Lwao/projeto-instalacoes-eletrica/diagramas/prumada-2-600.jpg

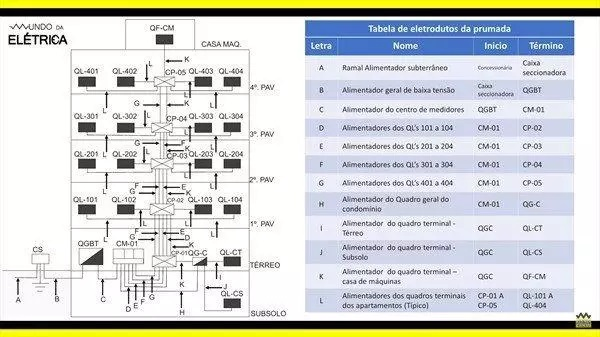
diagramas/prumada-2-600.jpg
