Lwao/projeto-instalacoes-eletrica/diagramas/detalhe2.pdf

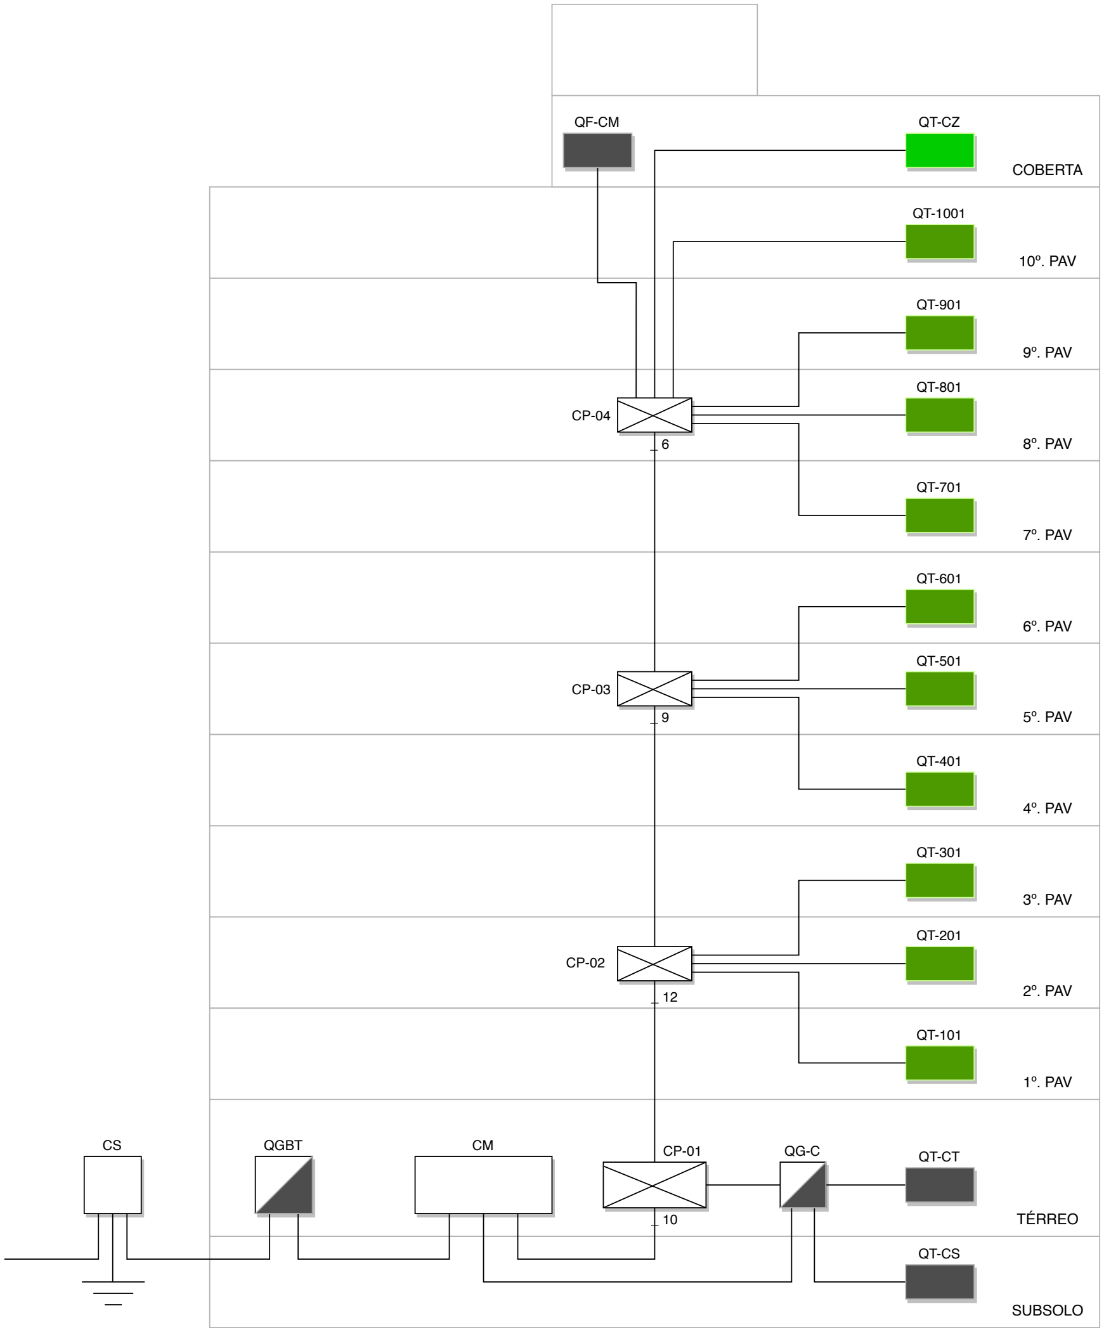
[picture p3: figure]
QGBT; SUBSOLO; TÉRREO; 1º. PAV; 2º. PAV; 3º. PAV; 4º. PAV; 5º. PAV; 6º. PAV; 7º. PAV; 8º. PAV; 9º. PAV; 10º. PAV; COBERTA
