Lwao/projeto-instalacoes-eletrica/exportacao/Anexos/Outros/partida.pdf

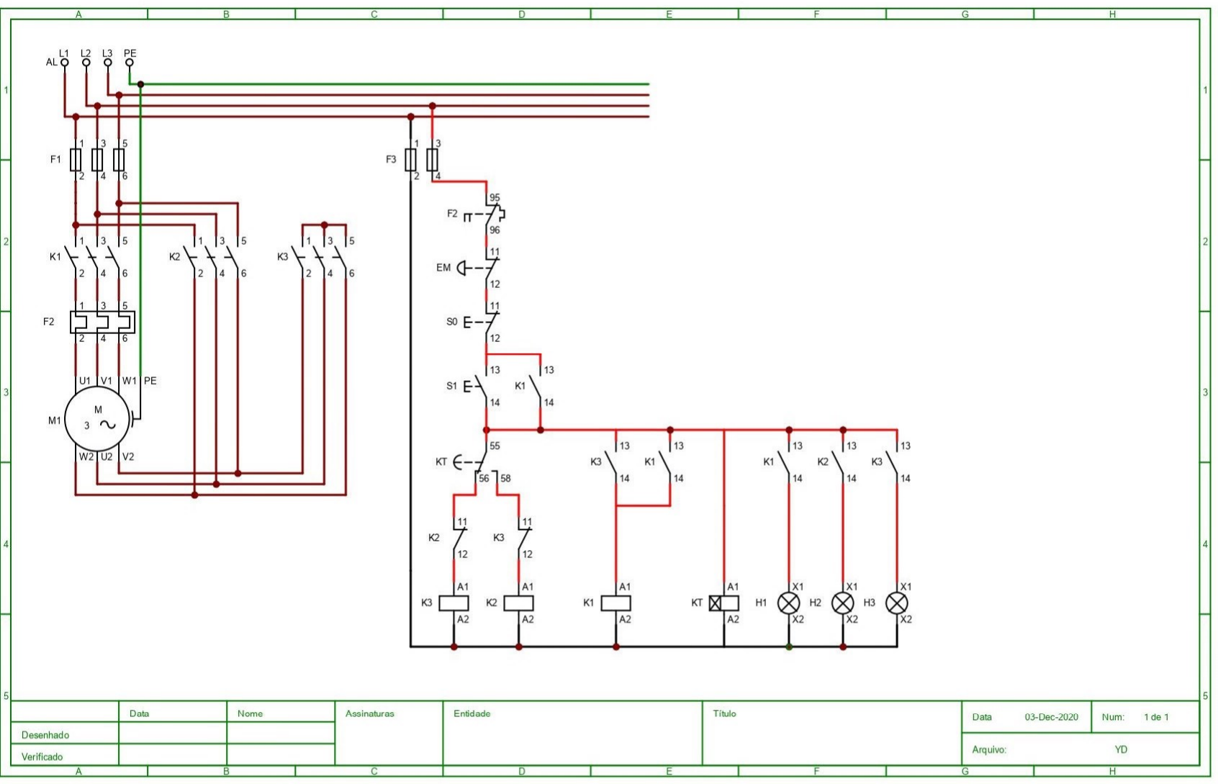
[picture p4: page 1]
