Lwao/projeto-instalacoes-eletrica/diagramas/0001.jpg

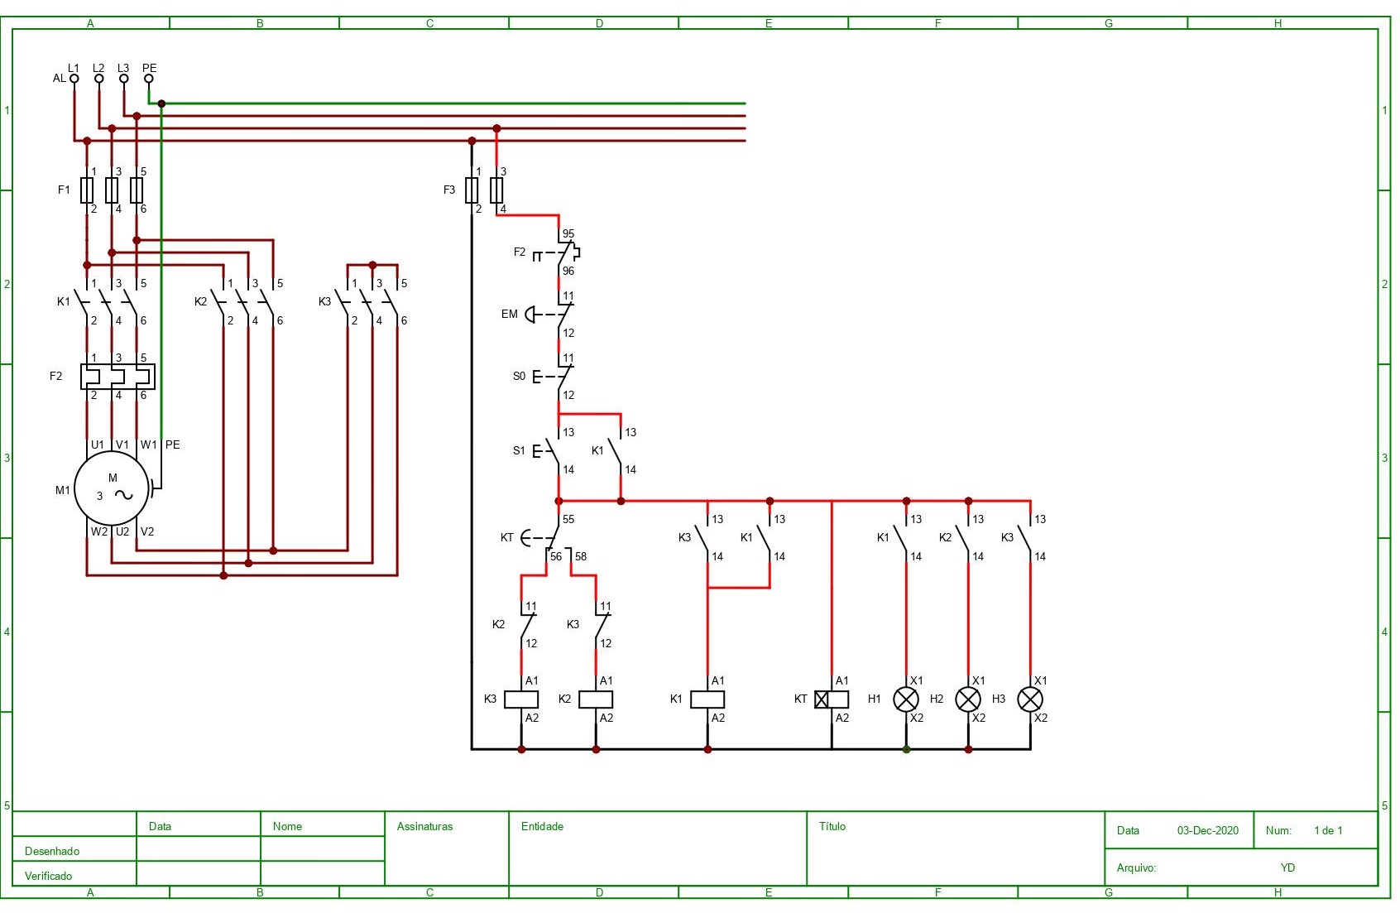
diagramas/0001.jpg
