Lwao/projeto-instalacoes-eletrica/diagramas/elevator.jpg

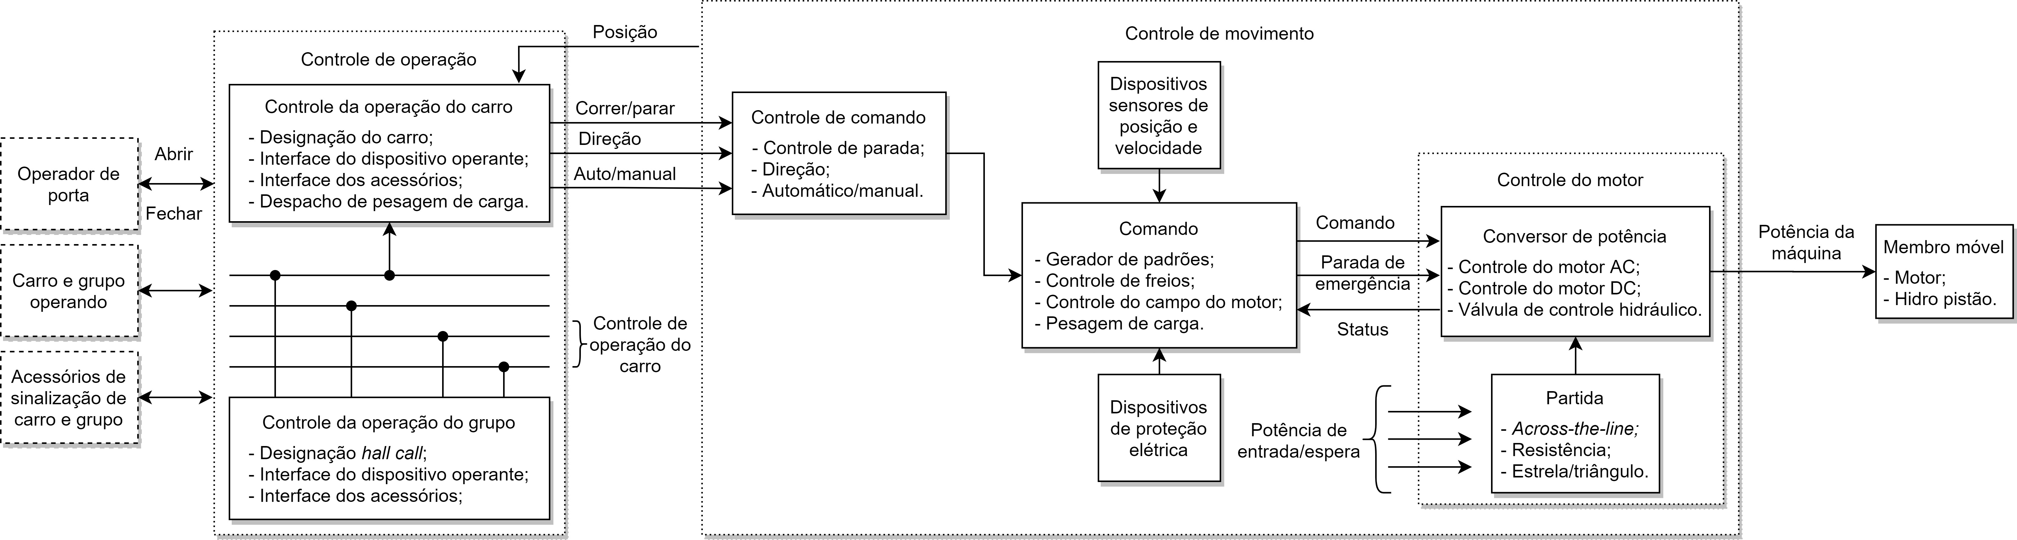
diagramas/elevator.jpg
