Lwao/projeto-instalacoes-eletrica/diagramas/esq_vert.png

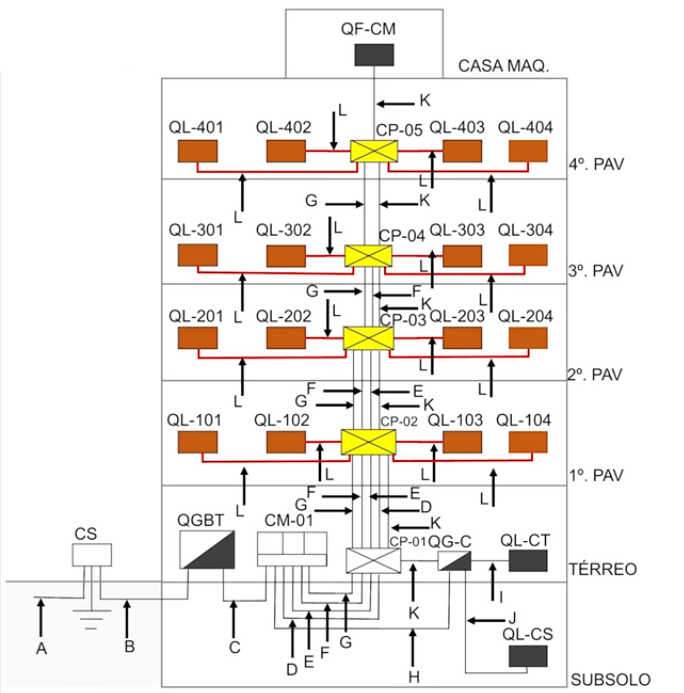
diagramas/esq_vert.png
