Lwao/projeto-instalacoes-eletrica/diagramas/unifilar.jpg

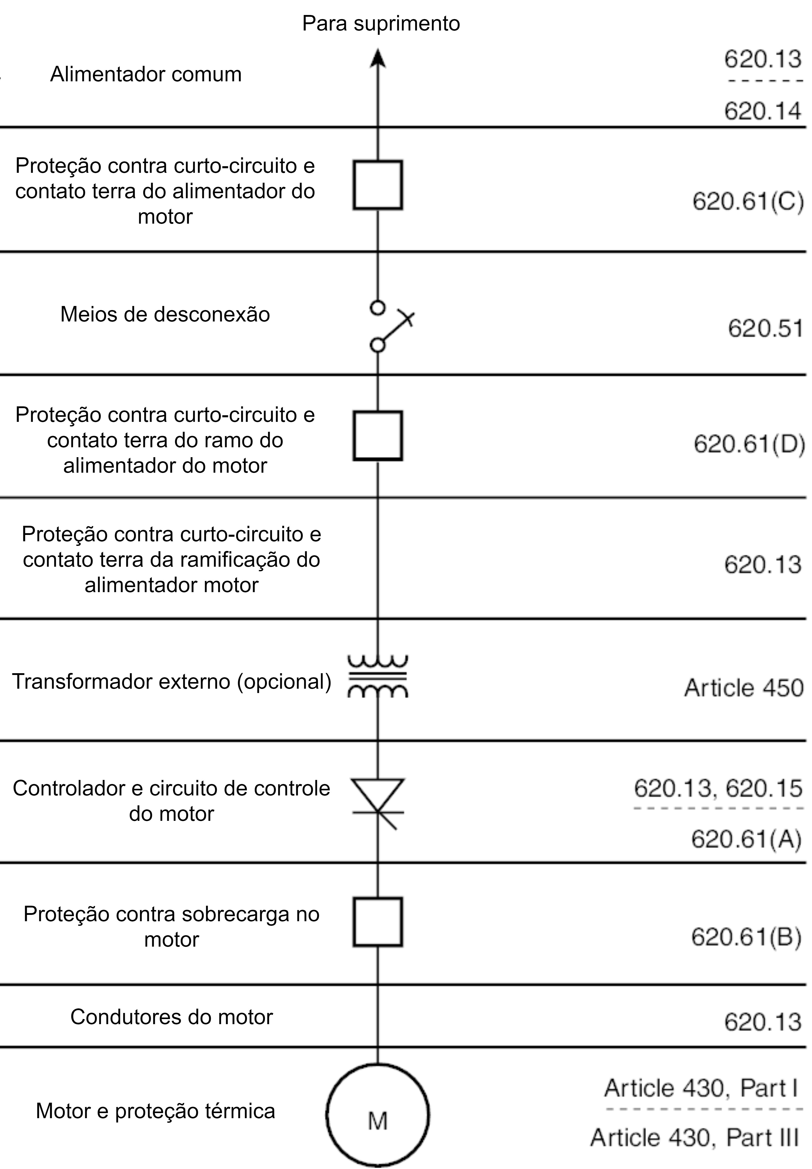
diagramas/unifilar.jpg
