Lwao/projeto-instalacoes-eletrica/(list of files, cad)

Other CAD files:
dwg/Detalhes/medidor-mureta.DWG
dwg/Editáveis/Planta e tabelas.dwg
dwg/Especificados/Projeto Arquitetônico - PPIEBT.dwg
dwg/Detalhes/Medidor-padrao-aereo.dwg
dwg/Editáveis/medicao.dwg
dwg/Especificados/Projeto_luminotécnico_externo.dwg
dwg/Detalhes/poste1.dwg
dwg/Especificados/Planta Baixa - Casa.dwg
dwg/Detalhes/TomadaPiso.dwg
dwg/Editáveis/projeto_v.0.2.0.dwg
dwg/Especificados/Edifcio_Residencial.dwg
dwg/Detalhes/Medidor-agrupado.dwg
dwg/Especificados/leg_eletrica.dwg
dwg/Detalhes/Interrupto3P.dwg
dwg/Detalhes/Caixa-Passagem-embutida-40x40.dwg
dwg/Detalhes/Bocal.dwg
dwg/Detalhes/Bucha-Arruela.dwg
dwg/Detalhes/Caixa-passagem-subterranea.dwg
dwg/Detalhes/PADRAO12.dwg
dwg/Detalhes/TubSubterranea.dwg
dwg/Detalhes/montagem-QD-GERAL.dwg
dwg/Detalhes/Posicionamento-luz-tomada.dwg
dwg/Detalhes/Ce3.dwg
dwg/Detalhes/Eletroduto-Entre-forro.dwg
dwg/Detalhes/Postealt.dwg
dwg/Detalhes/PADRAO8.dwg
dwg/Detalhes/Caixa-zc.dwg
dwg/Detalhes/InterruptorFourWay.dwg
dwg/Detalhes/PADRAO6.dwg
dwg/Detalhes/Caixa-zc-Drenada.dwg
dwg/Detalhes/POSTE.dwg
dwg/Detalhes/ZCPasseio.dwg
dwg/Detalhes/Caixa-zc-Drenada2.dwg
dwg/Detalhes/Detalhe-aterramento.dwg
dwg/Detalhes/PADRAO4.dwg
dwg/Detalhes/Cx-Inspeção-Aterra-Circuito.dwg
dwg/Detalhes/Cx-Inspeção-Aterra.dwg
dwg/Detalhes/InterruptorThreeWay.dwg
dwg/Detalhes/Cores-Barramento-AT.dwg
dwg/Detalhes/CAMMODI.dwg
dwg/Detalhes/CAMMODII.dwg
dwg/Detalhes/TAMPACAM.dwg
dwg/Detalhes/Caixa-zb.dwg
dwg/Detalhes/REX.dwg
dwg/Detalhes/TRAVESSA.dwg
dwg/Detalhes/Detalhe-aterramento+haste.dwg
dwg/Detalhes/Interrupto1P.dwg
dwg/Detalhes/Alimentação-subterranea.dwg
dwg/Editáveis/projeto_v.0.0.40.dwg
