Lwao/projeto-instalacoes-eletrica/exportacao/Anexos/Tabelas/tabela_cargas_apto.pdf

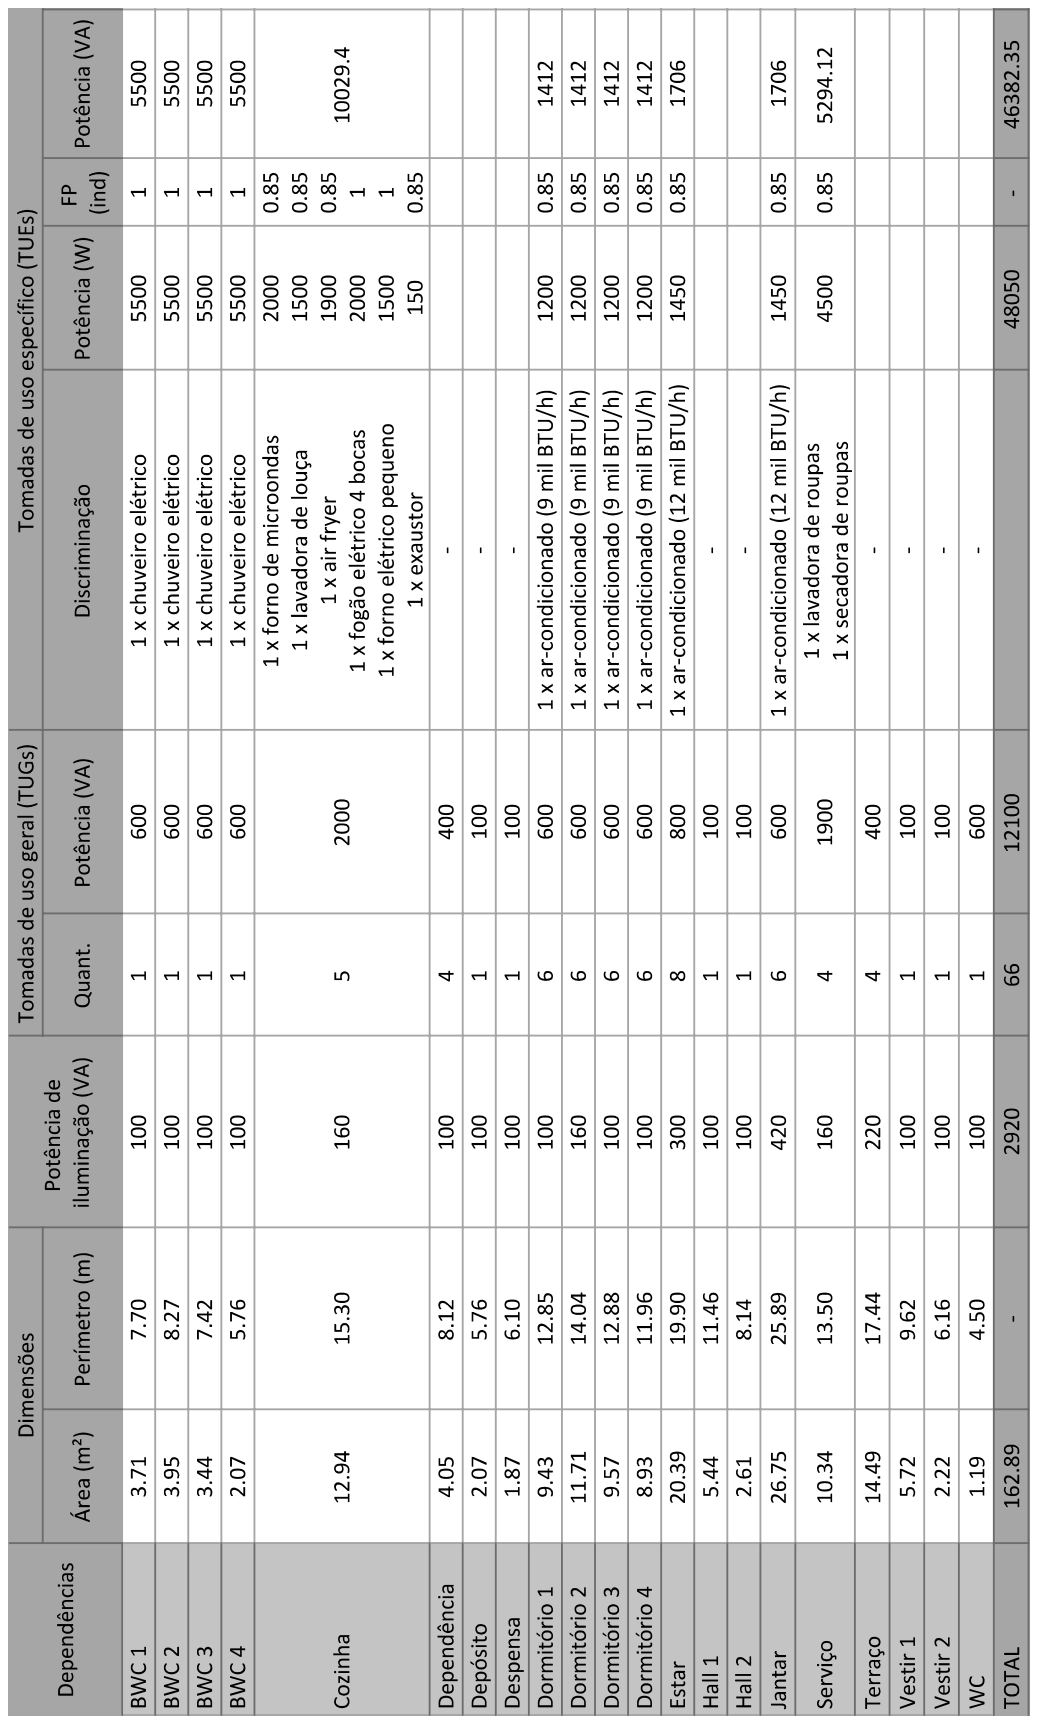
[picture p31: page 1]
