Lwao/projeto-instalacoes-eletrica/exportacao/Anexos/Tabelas/tabela_cargas_maquinas.pdf

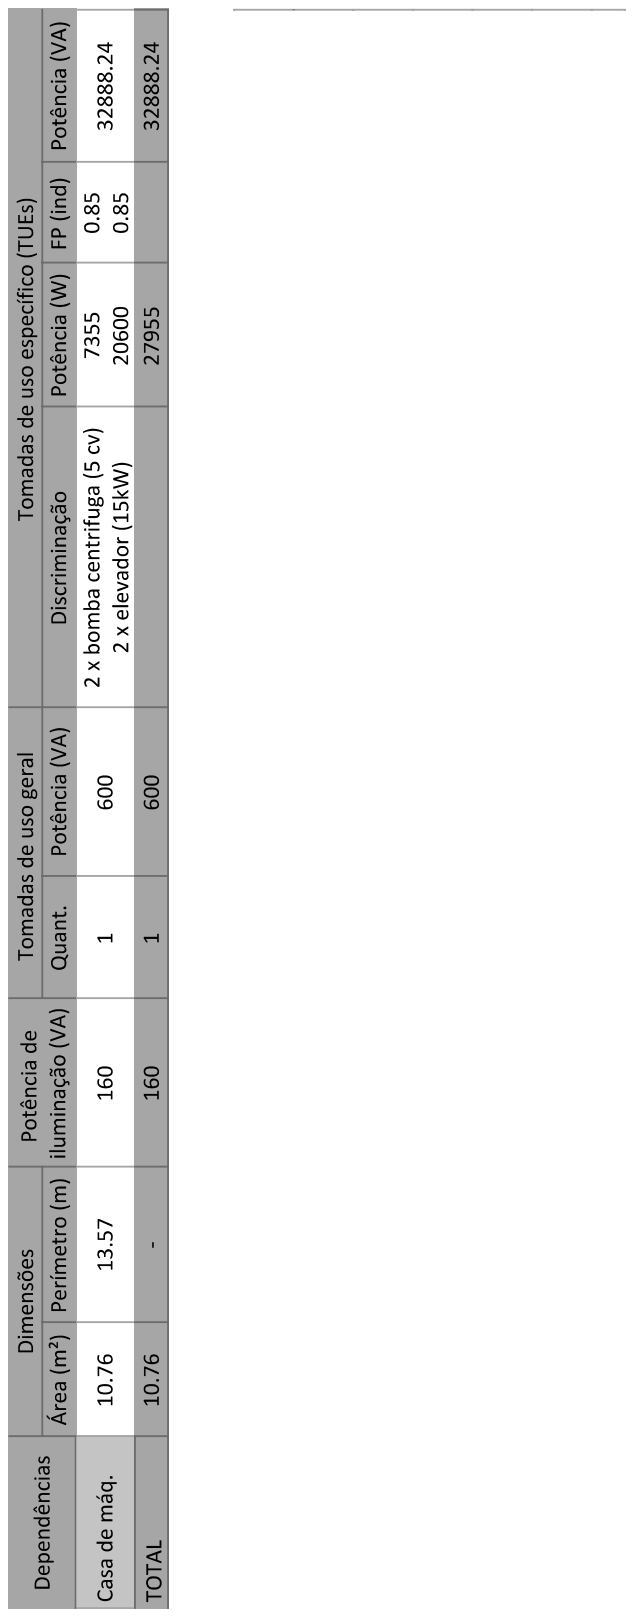
[picture p32: page 1]
