Lwao/projeto-instalacoes-eletrica/exportacao/Anexos/Tabelas/tabela_cargas_subsolo.pdf

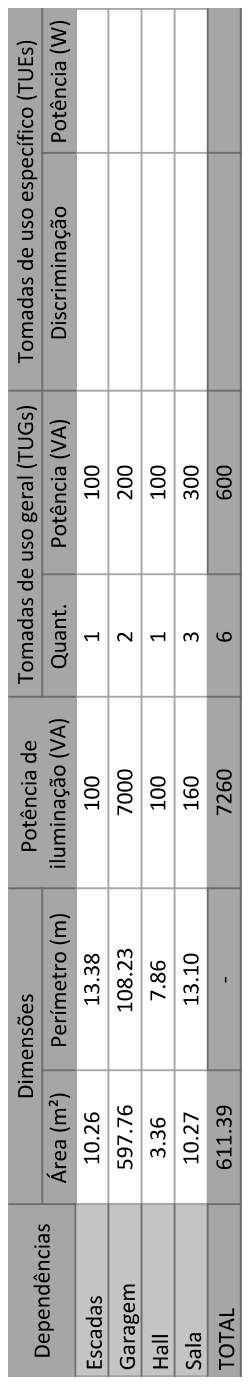
[picture p33: page 1]
