Lwao/projeto-instalacoes-eletrica/exportacao/Anexos/Tabelas/tabela_cargas_terreo.pdf

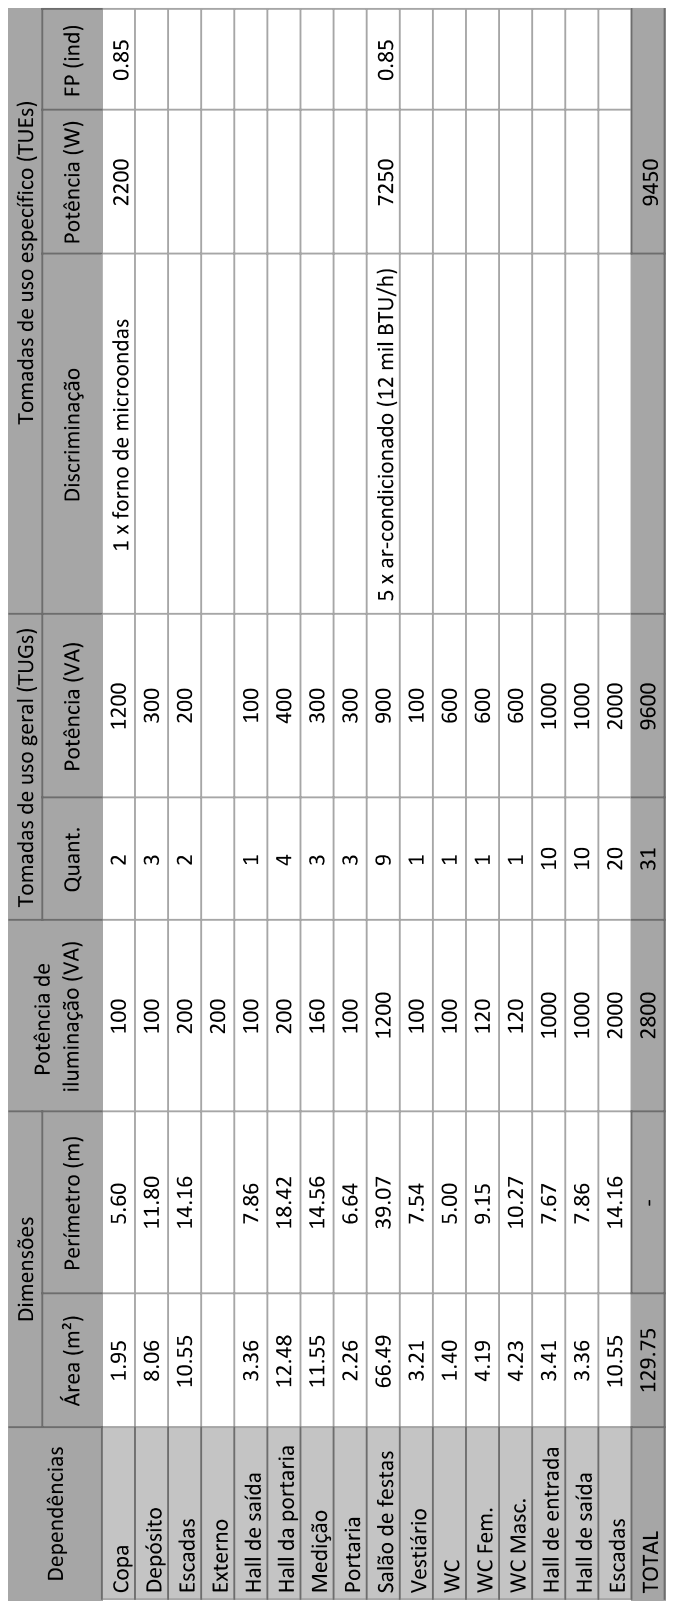
[picture p34: page 1]
