Lwao/projeto-instalacoes-eletrica/exportacao/Anexos/Tabelas/tabela_cargas_zelador.pdf

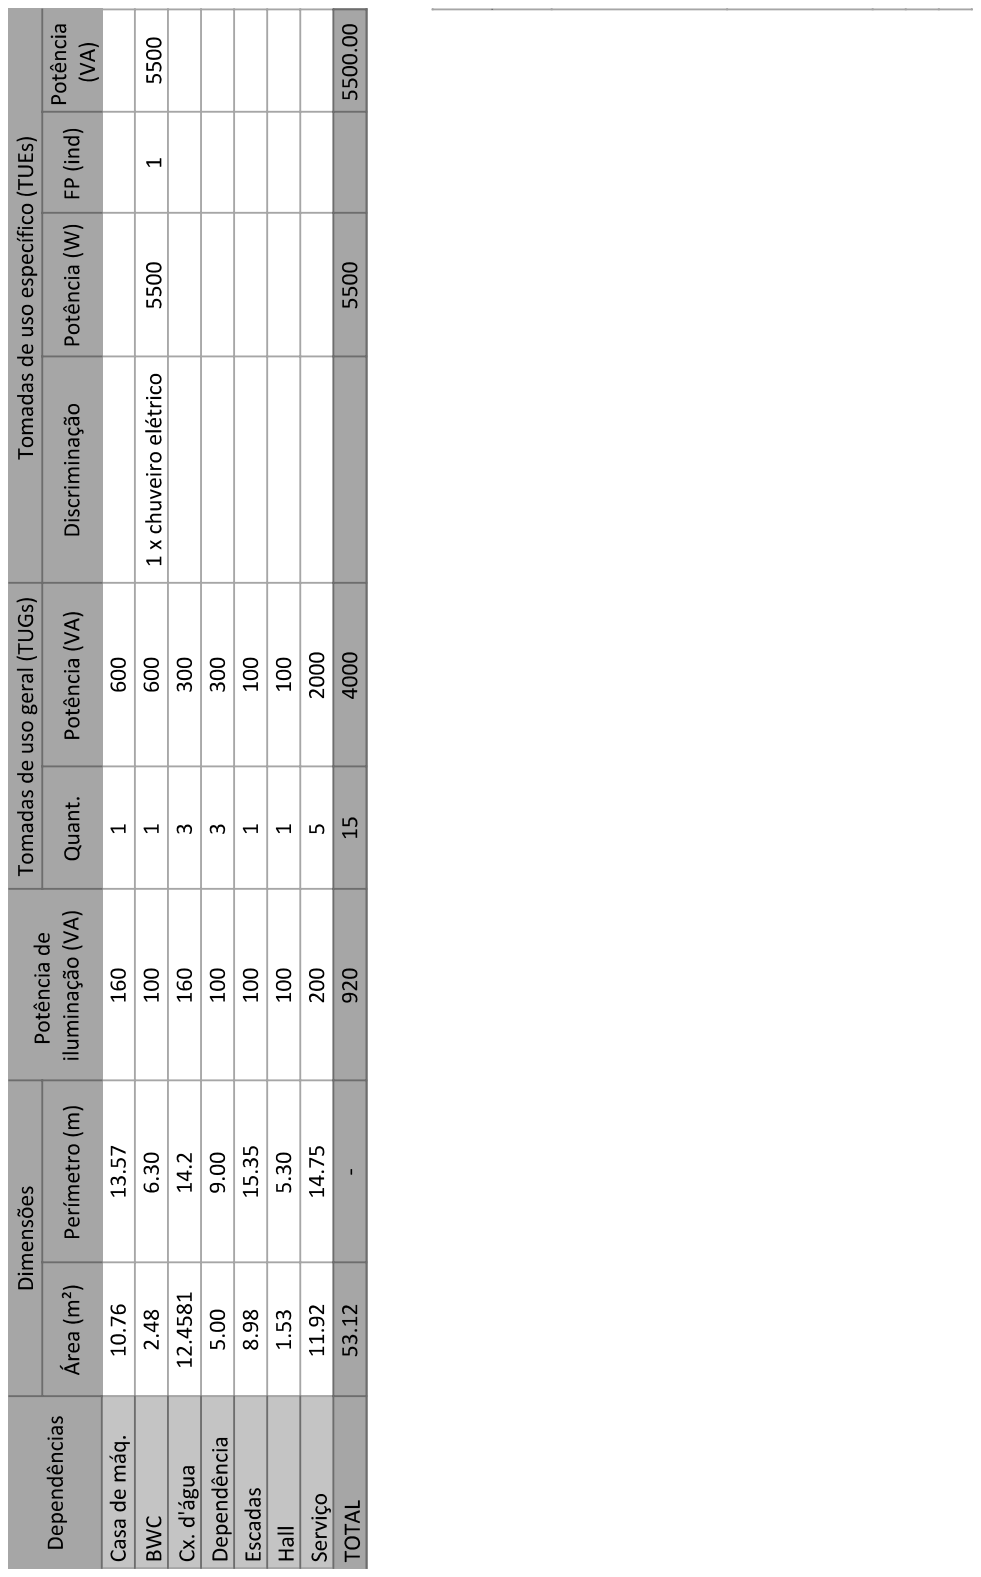
[picture p35: page 1]
