Lwao/projeto-instalacoes-eletrica/exportacao/Anexos/Tabelas/tabela_circuitos_apto.pdf

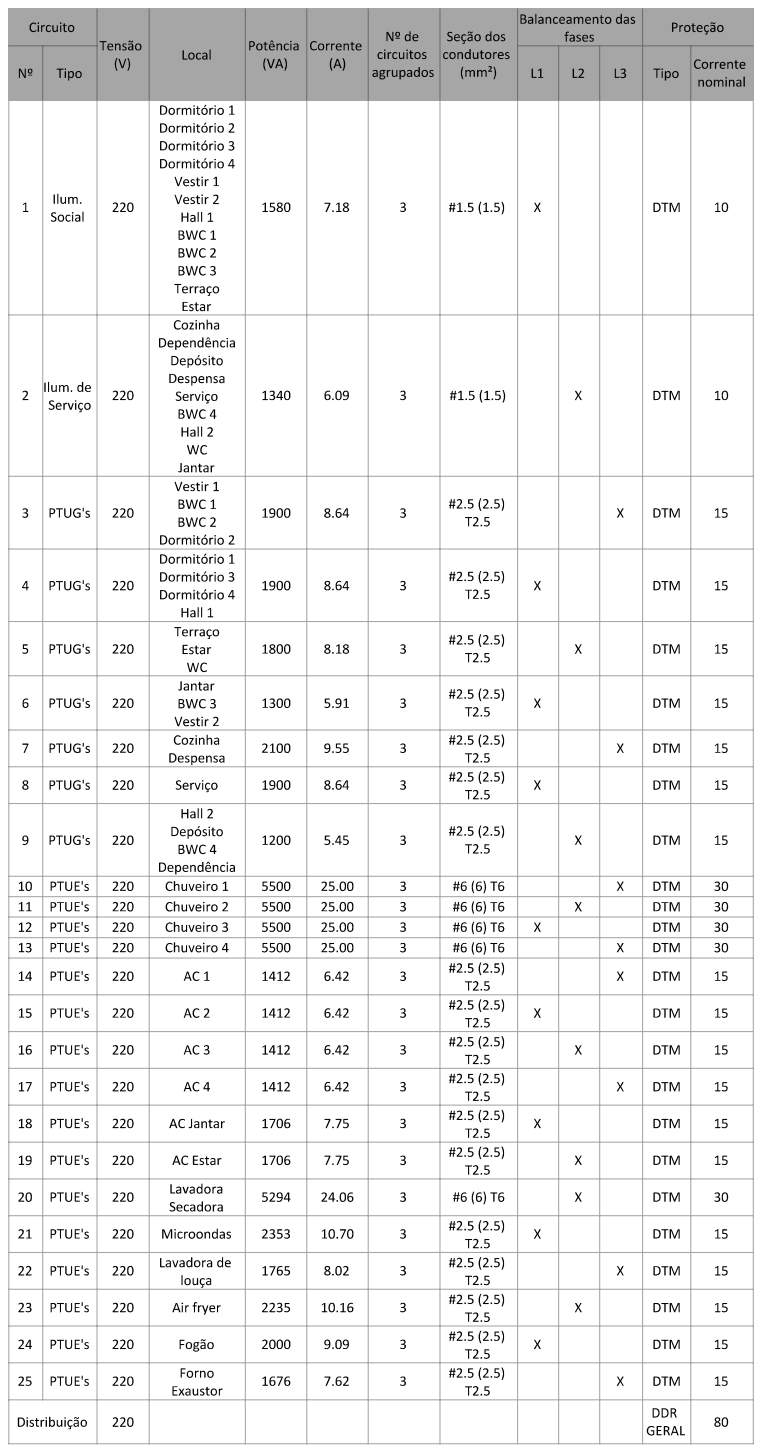
[picture p36: page 1]
