Lwao/projeto-instalacoes-eletrica/exportacao/Anexos/Tabelas/tabela_circuitos_maquinas.pdf

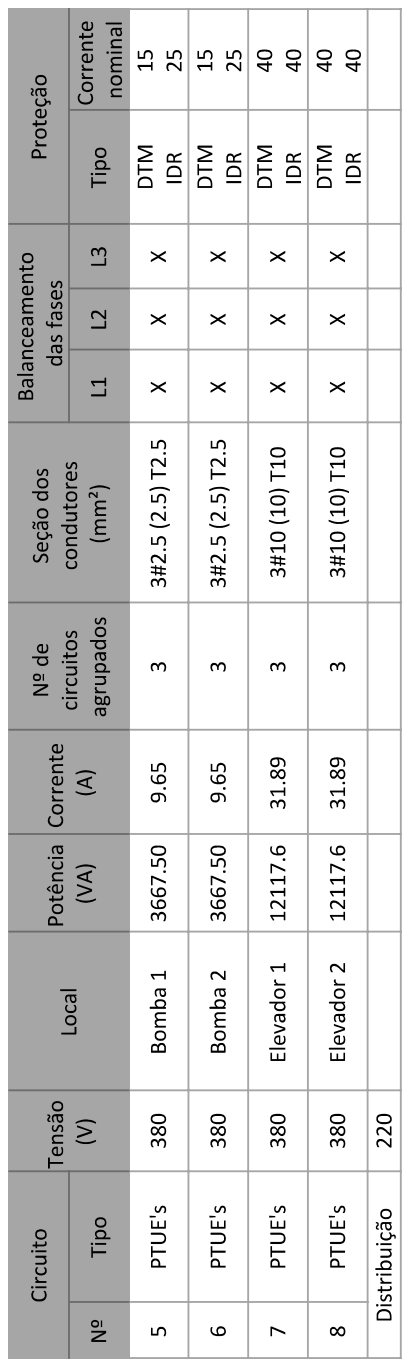
[picture p37: page 1]
