Lwao/projeto-instalacoes-eletrica/exportacao/Anexos/Tabelas/tabela_circuitos_subsolo.pdf

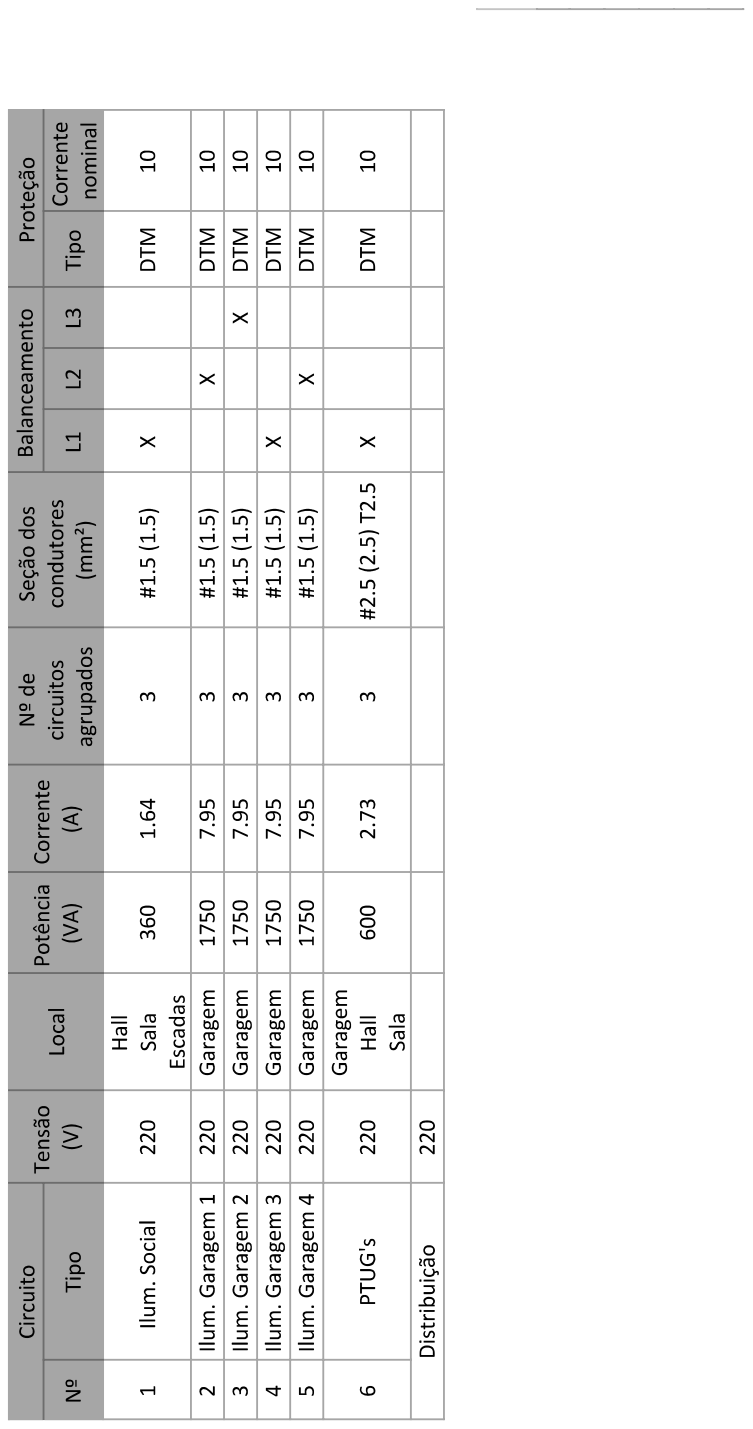
[picture p38: page 1]
