Lwao/projeto-instalacoes-eletrica/exportacao/Anexos/Tabelas/tabela_circuitos_terreo.pdf

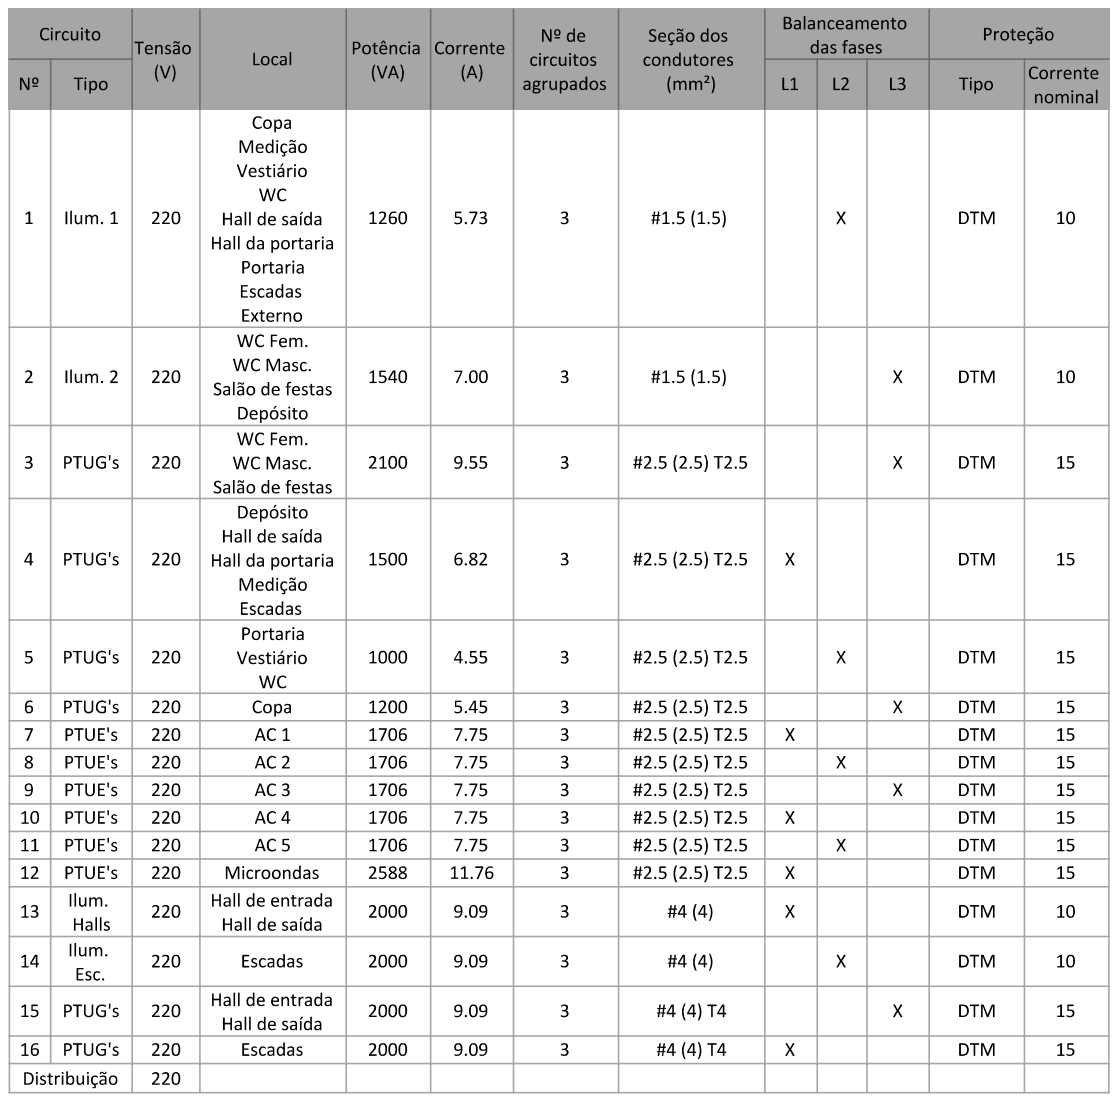
[picture p39: page 1]
