Lwao/projeto-instalacoes-eletrica/exportacao/Anexos/Tabelas/tabela_circuitos_zelador.pdf

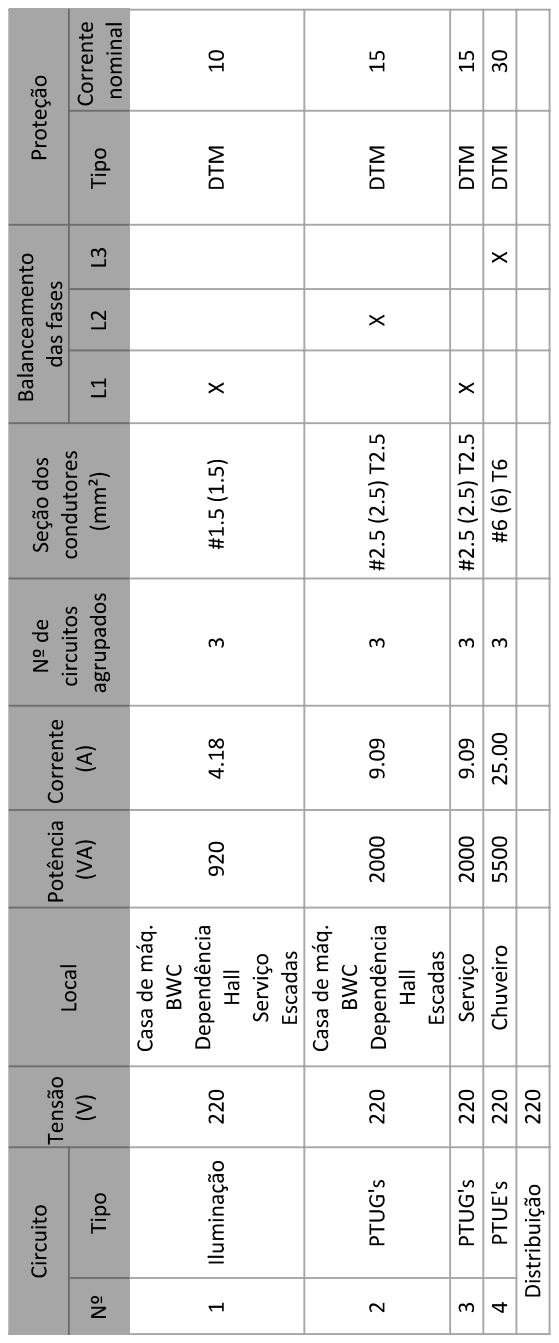
[picture p40: page 1]
