Lwao/projeto-instalacoes-eletrica/exportacao/Anexos/Tabelas/tabela_prumada.pdf

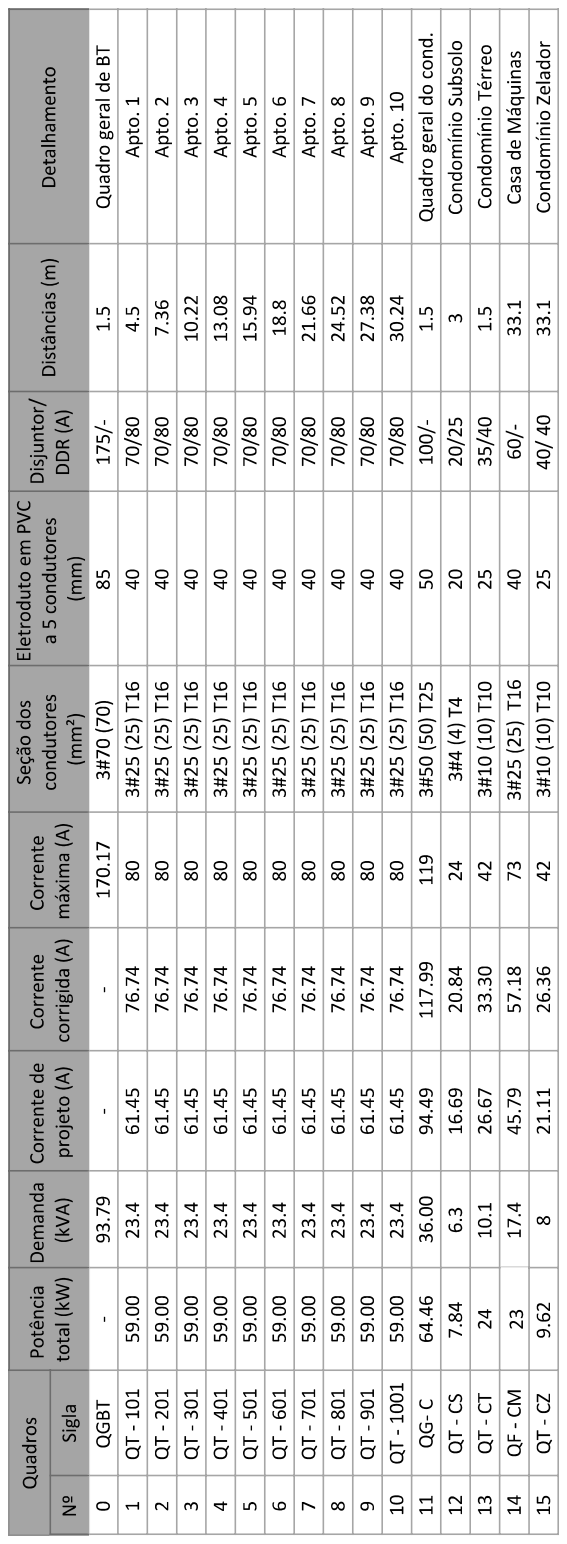
[picture p41: page 1]
