Lwao/projeto-instalacoes-eletrica/exportacao/Anexos/Plantas baixas/planta_terreo.pdf

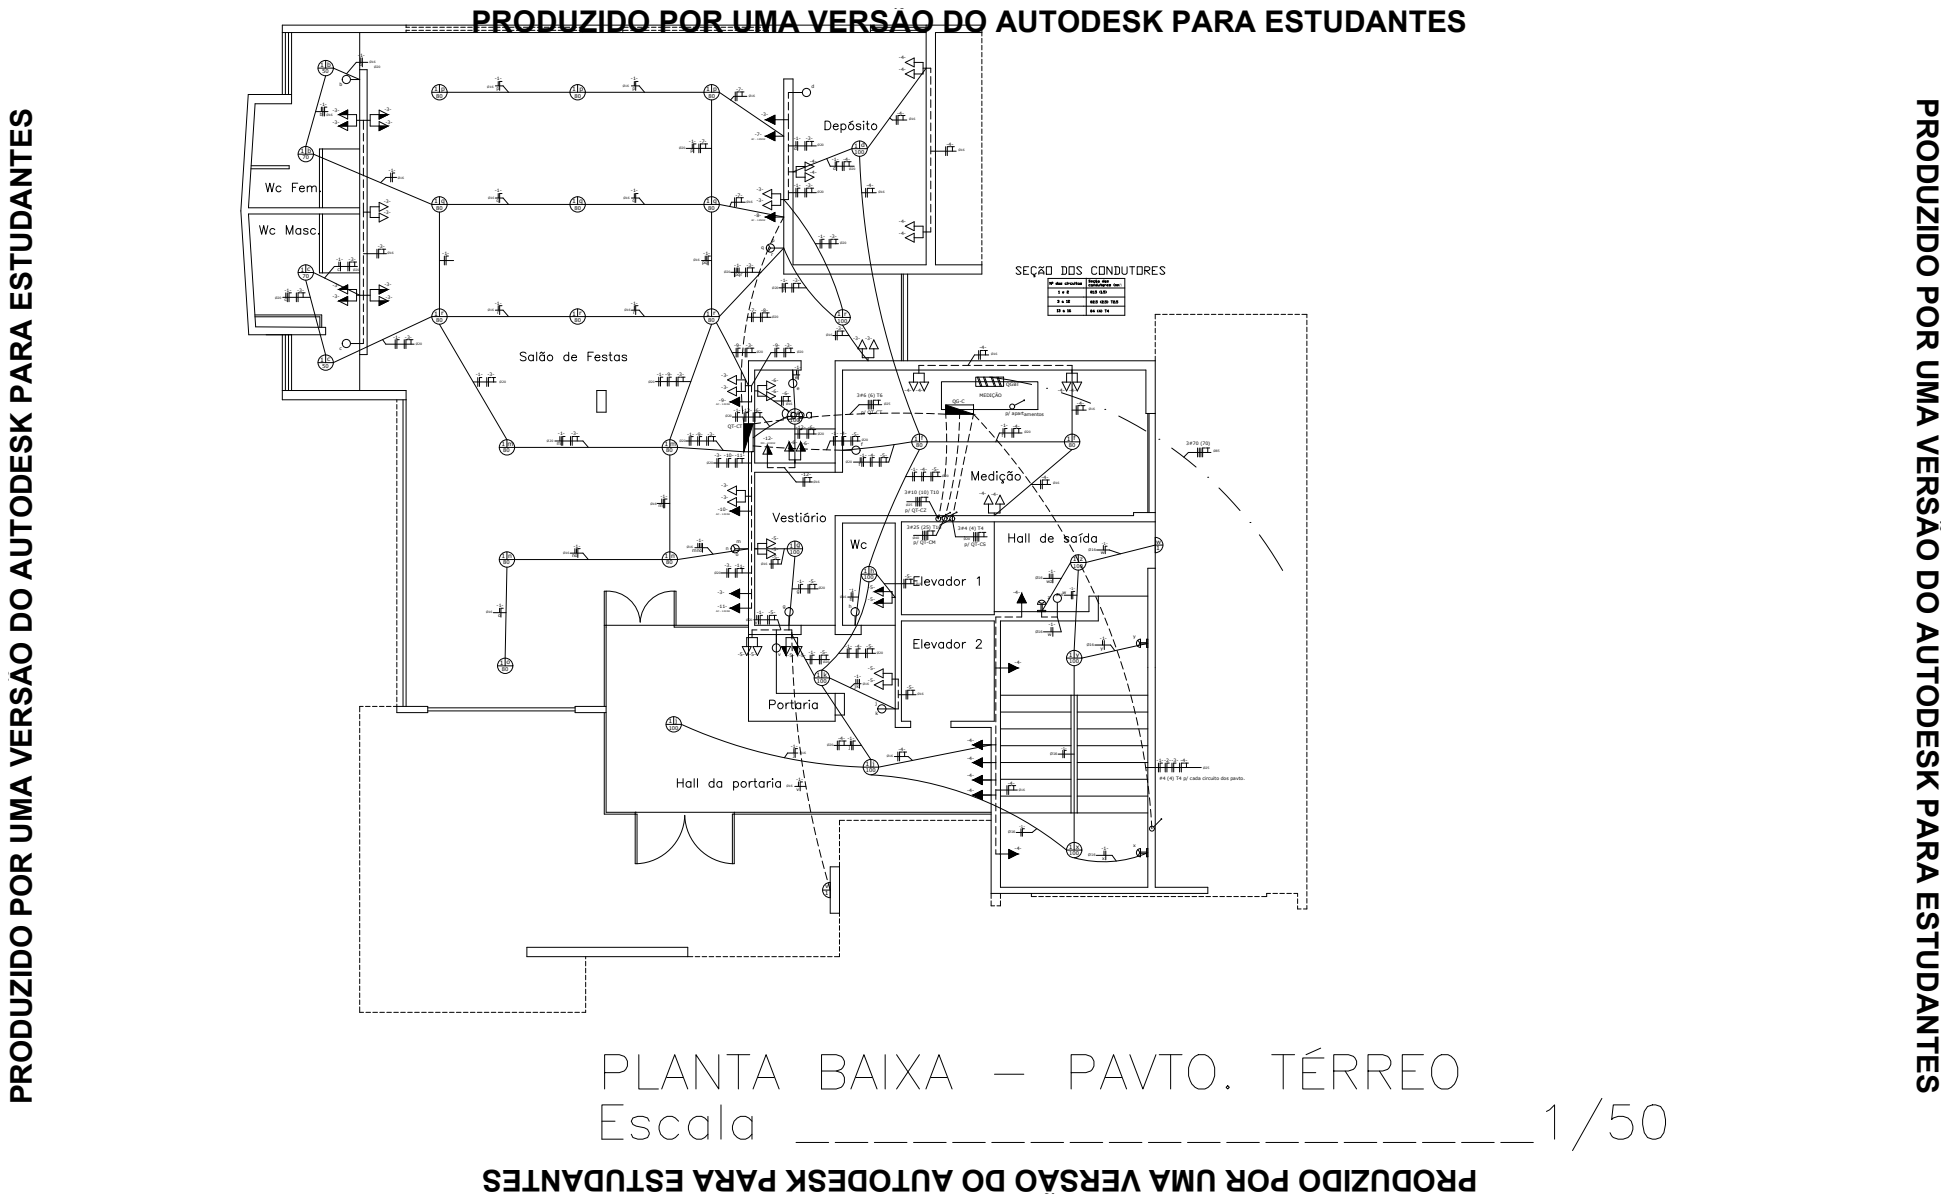
[picture p9: page 1]
-1- mno; -1- pqr; QGBT; p/ apartamentos

²) PRODUZIDO POR UMA VERSÃO DO AUTODESK PARA ESTUDANTES PRODUZIDO POR UMA VERSÃO DO AUTODESK PARA ESTUDANTES

#4 (4) T4 p/ cada circuito dos pavto.
