Lwao/projeto-instalacoes-eletrica/diagramas/YD_starter.pdf

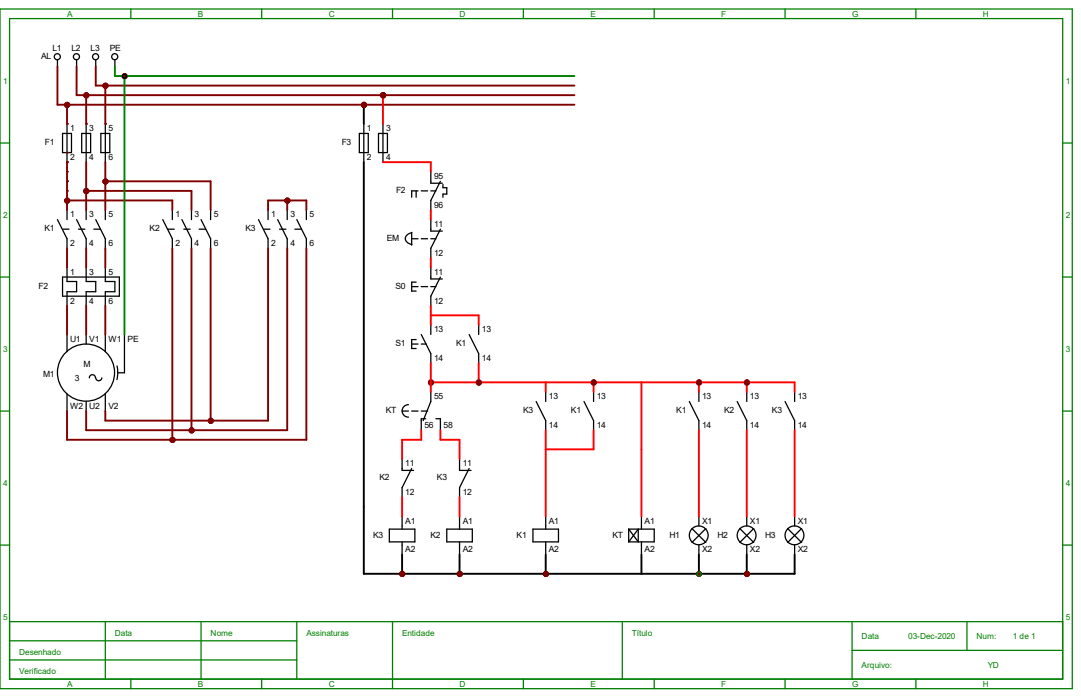
[picture p10: page 1]
Arquivo:

Data | Nome | Assinaturas | Entidade | Título | Data 03-Dec-2020 | Num: 1 de 1

Desenhado

Verificado
