Lwao/projeto-instalacoes-eletrica/exportacao/Anexos/divisao_dos_circuitos.pdf

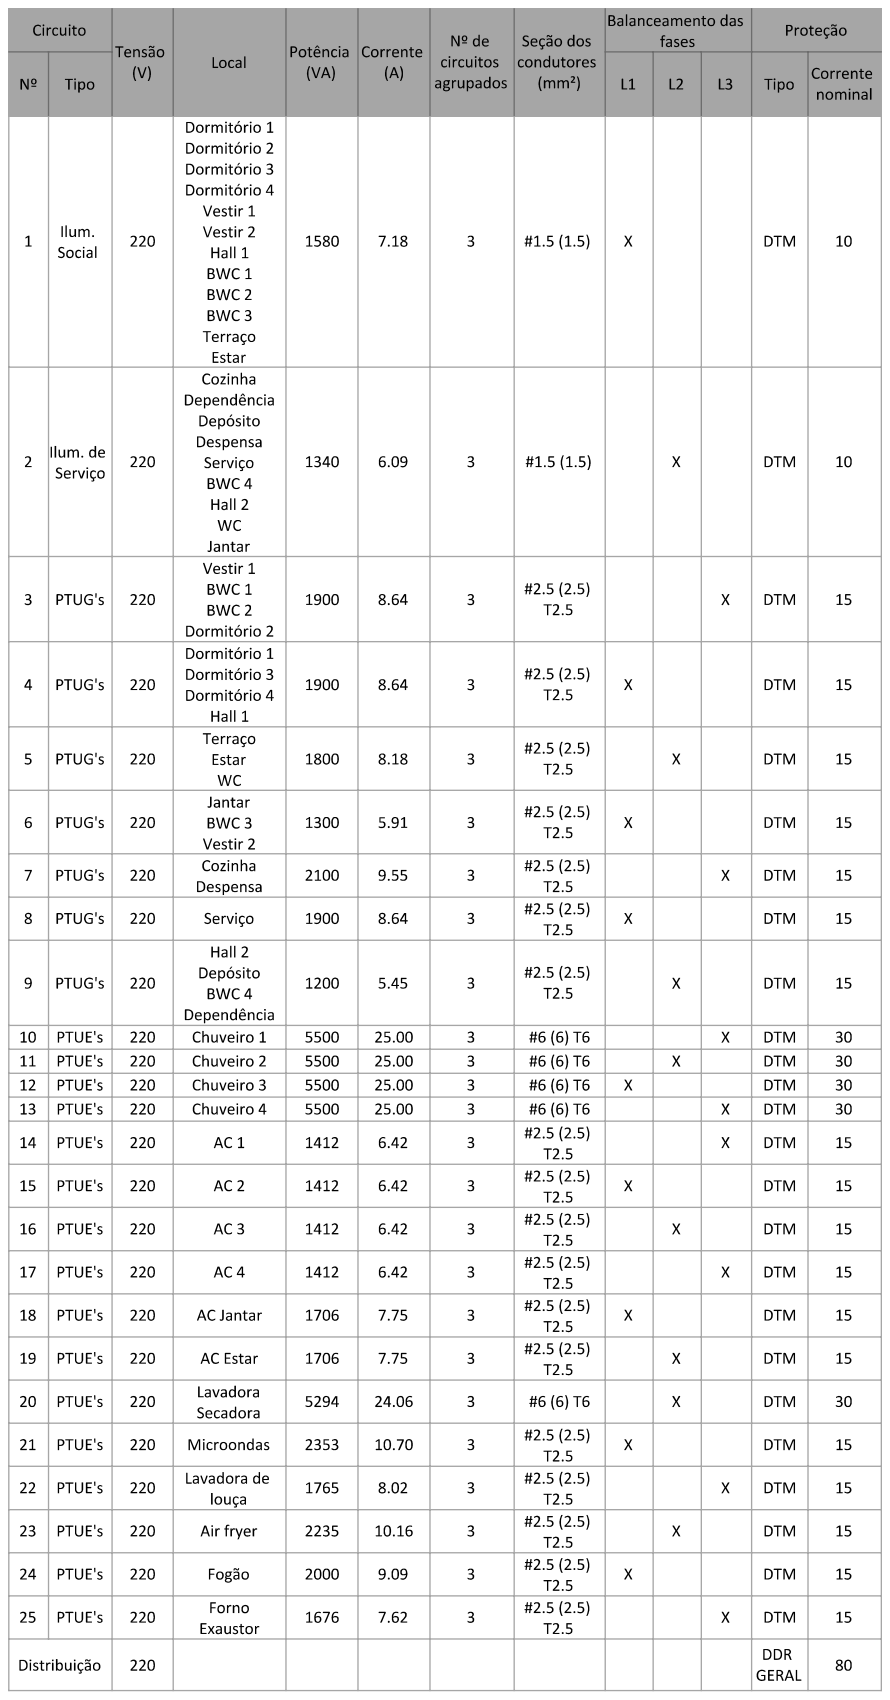
[picture p11: page 1]
