Lwao/projeto-instalacoes-eletrica/exportacao/Anexos/planta_baixa_apto_tipo.pdf

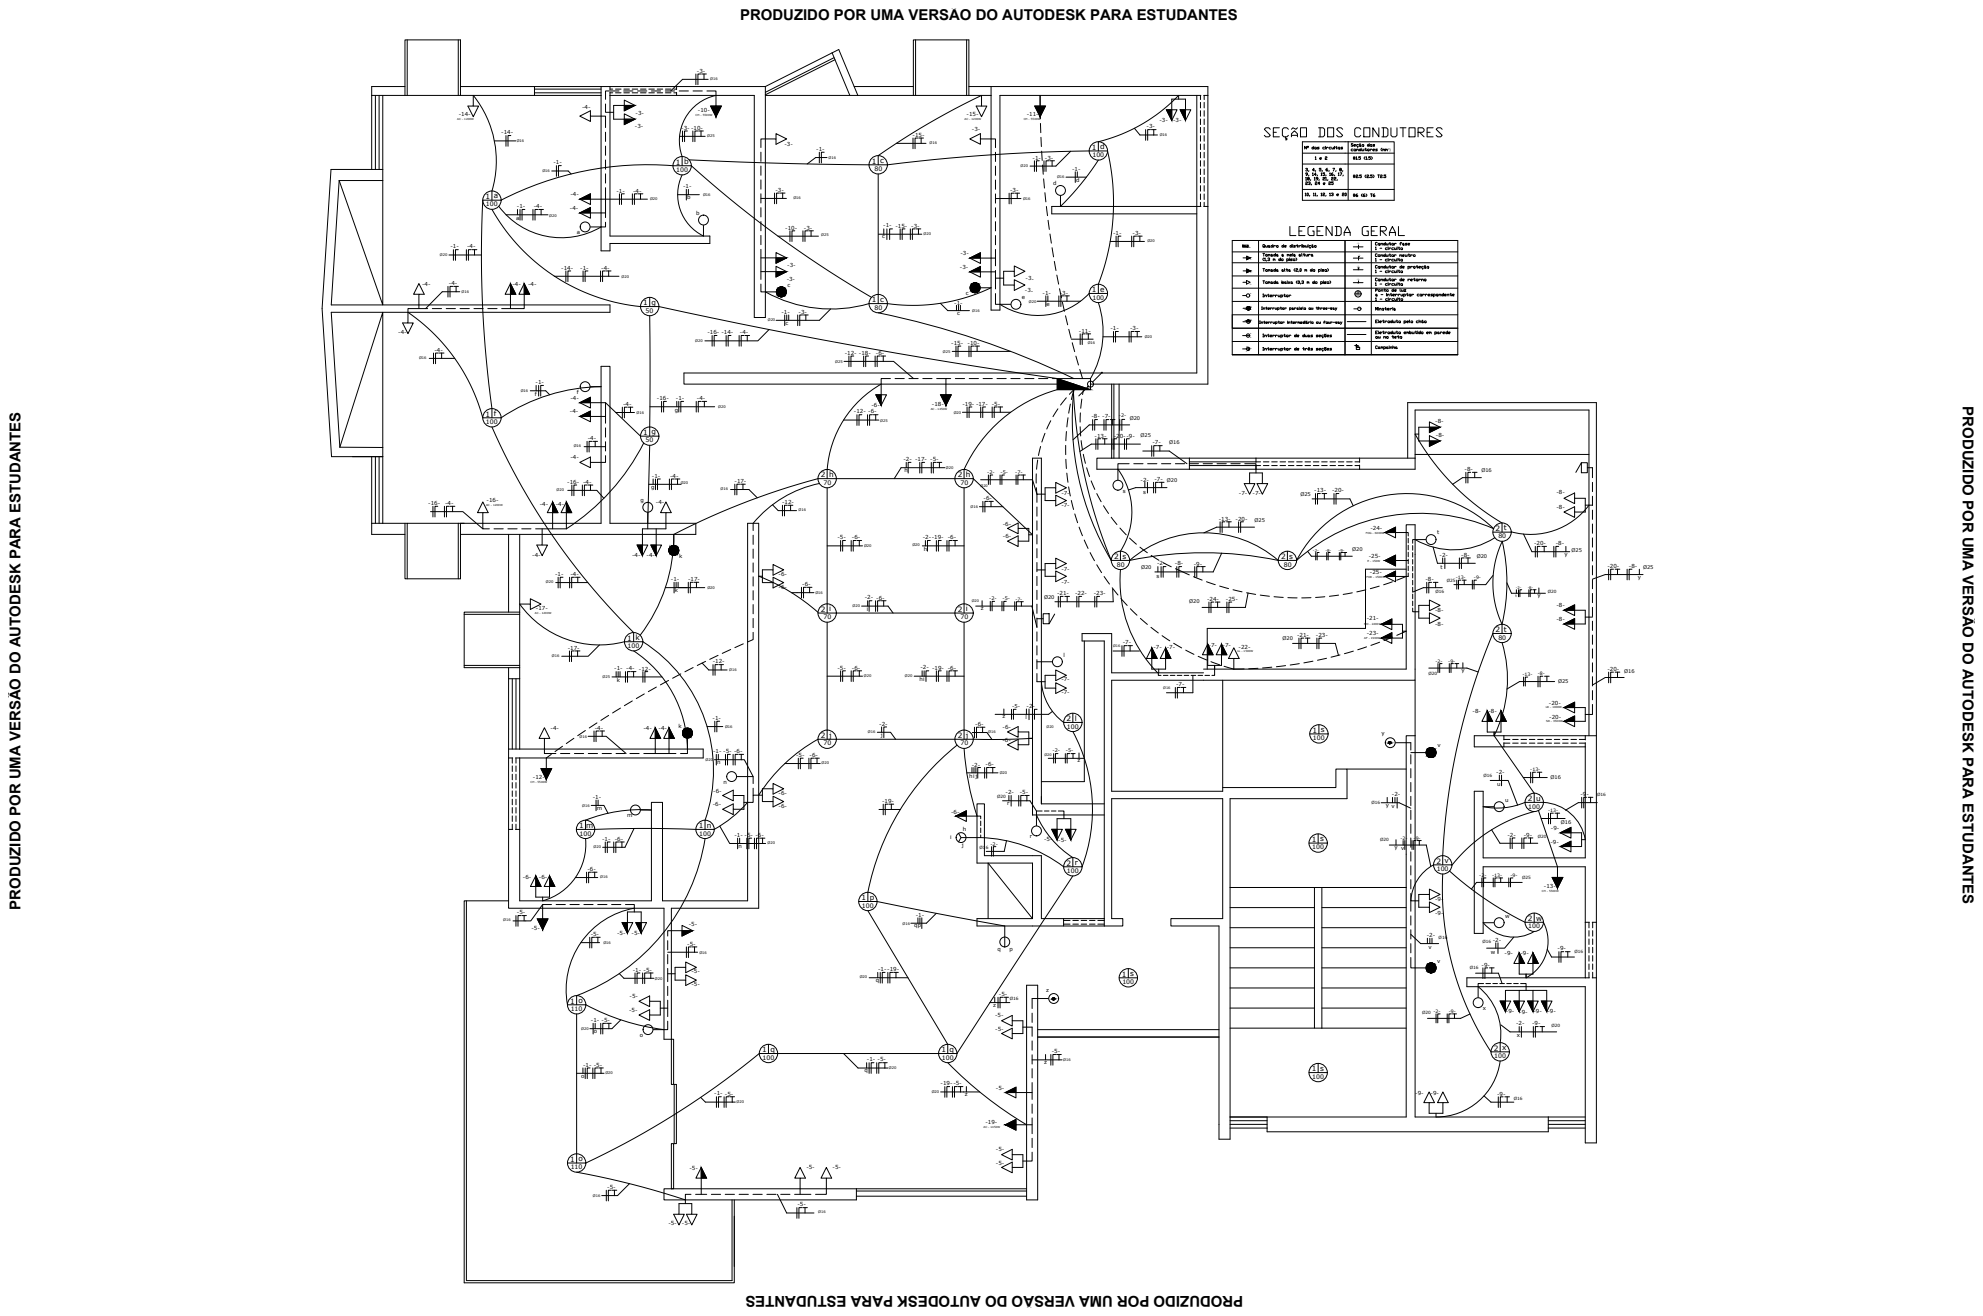
[picture p12: page 1]
FOR - 1500W; FOG - 6000W

²) PRODUZIDO POR UMA VERSÃO DO AUTODESK PARA ESTUDANTES PRODUZIDO POR UMA VERSÃO DO AUTODESK PARA ESTUDANTES

-1-M aaabb ac a -1-
