Lwao/projeto-instalacoes-eletrica/exportacao/Anexos/QT_unifilar.pdf

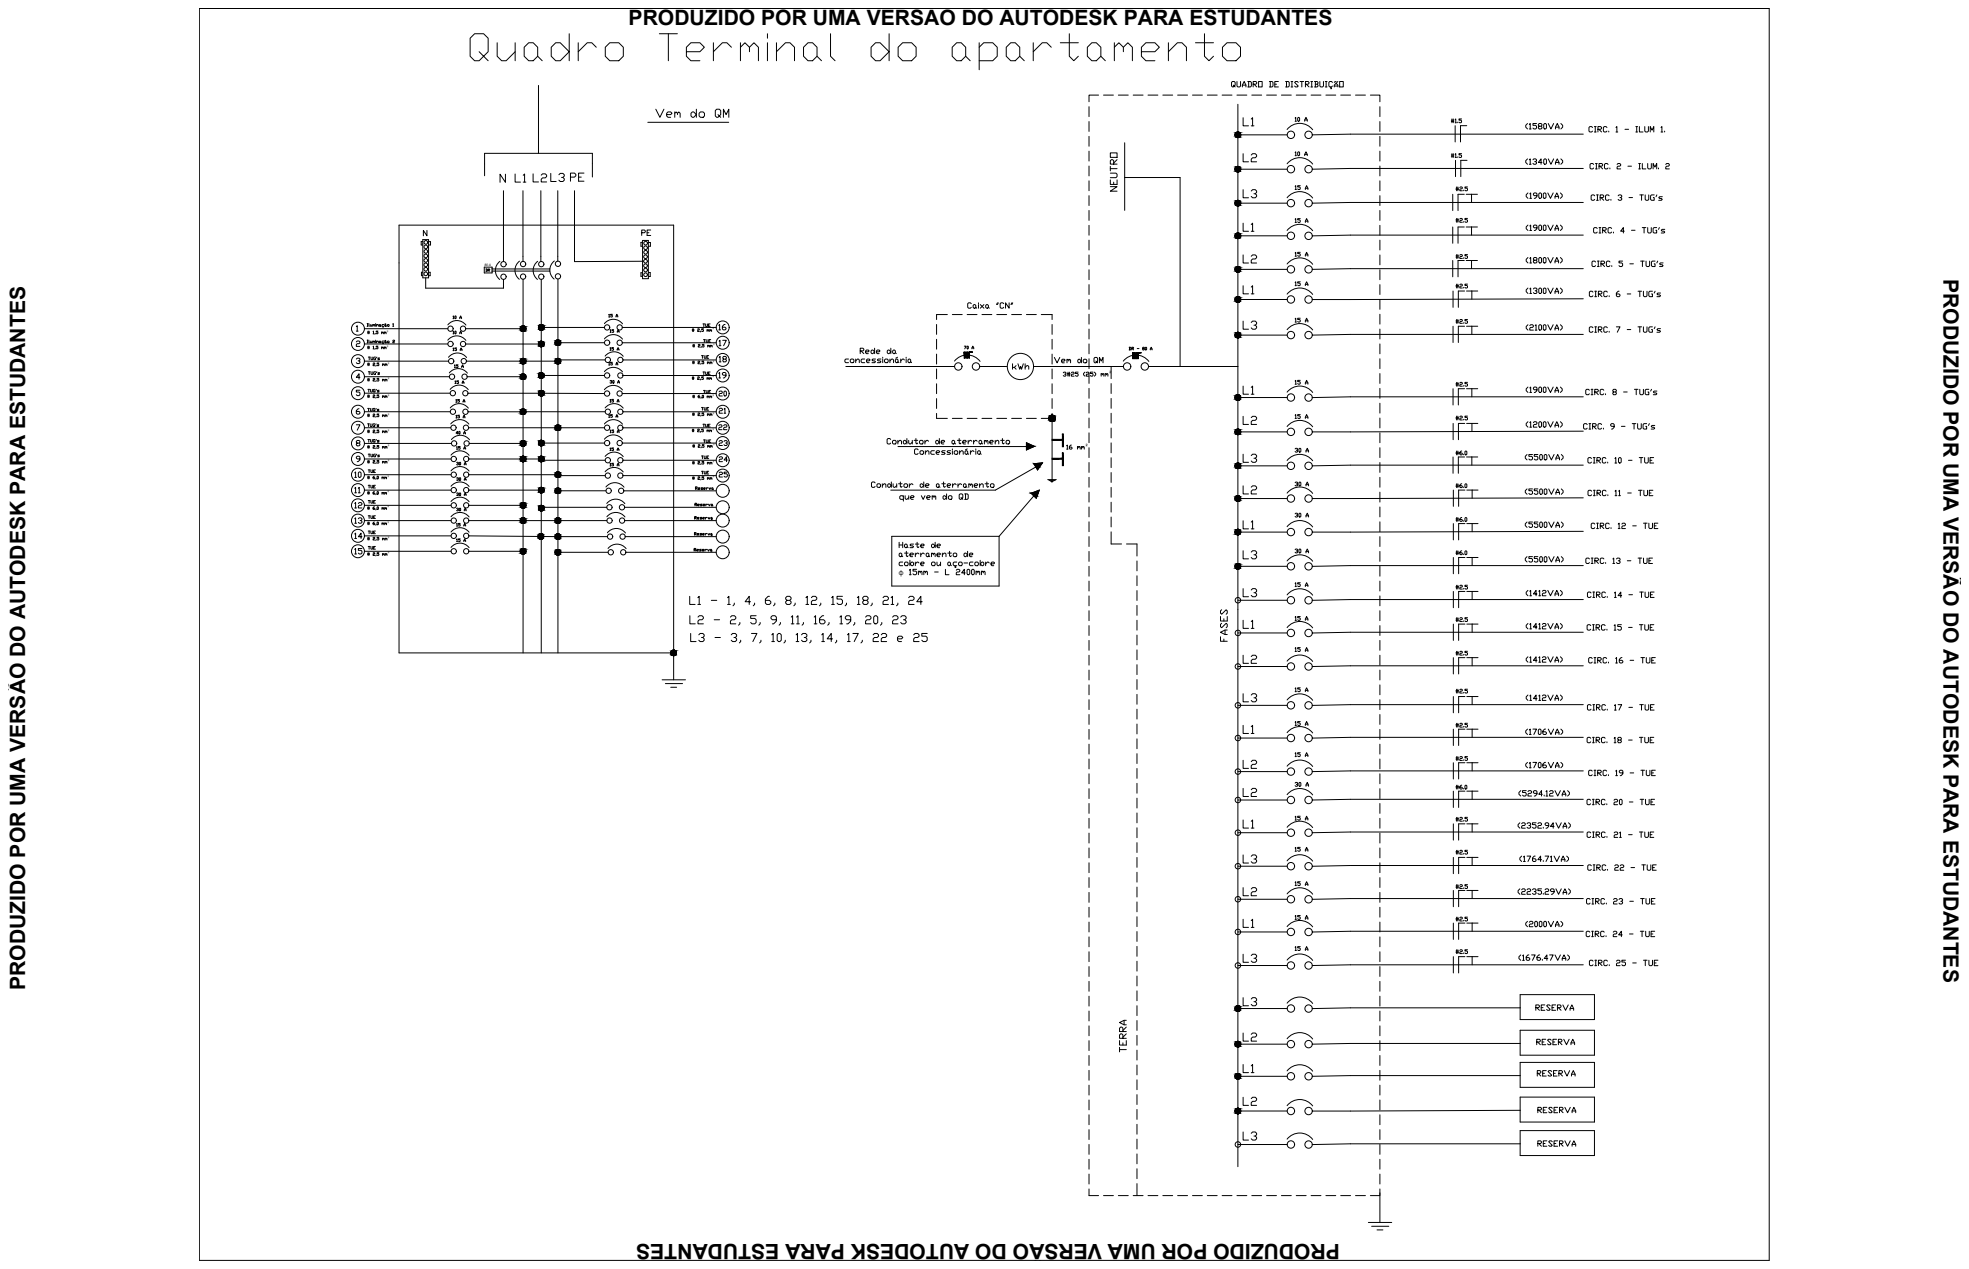
[picture p13: page 1]
80 A ²²²²²²²²²; ²²²; ² ²²²²²²; ²²²²²²²

PRODUZIDO POR UMA VERSÃO DO AUTODESK PARA ESTUDANTES
