Lwao/projeto-instalacoes-eletrica/exportacao/Anexos/quadro_de_cargas.pdf

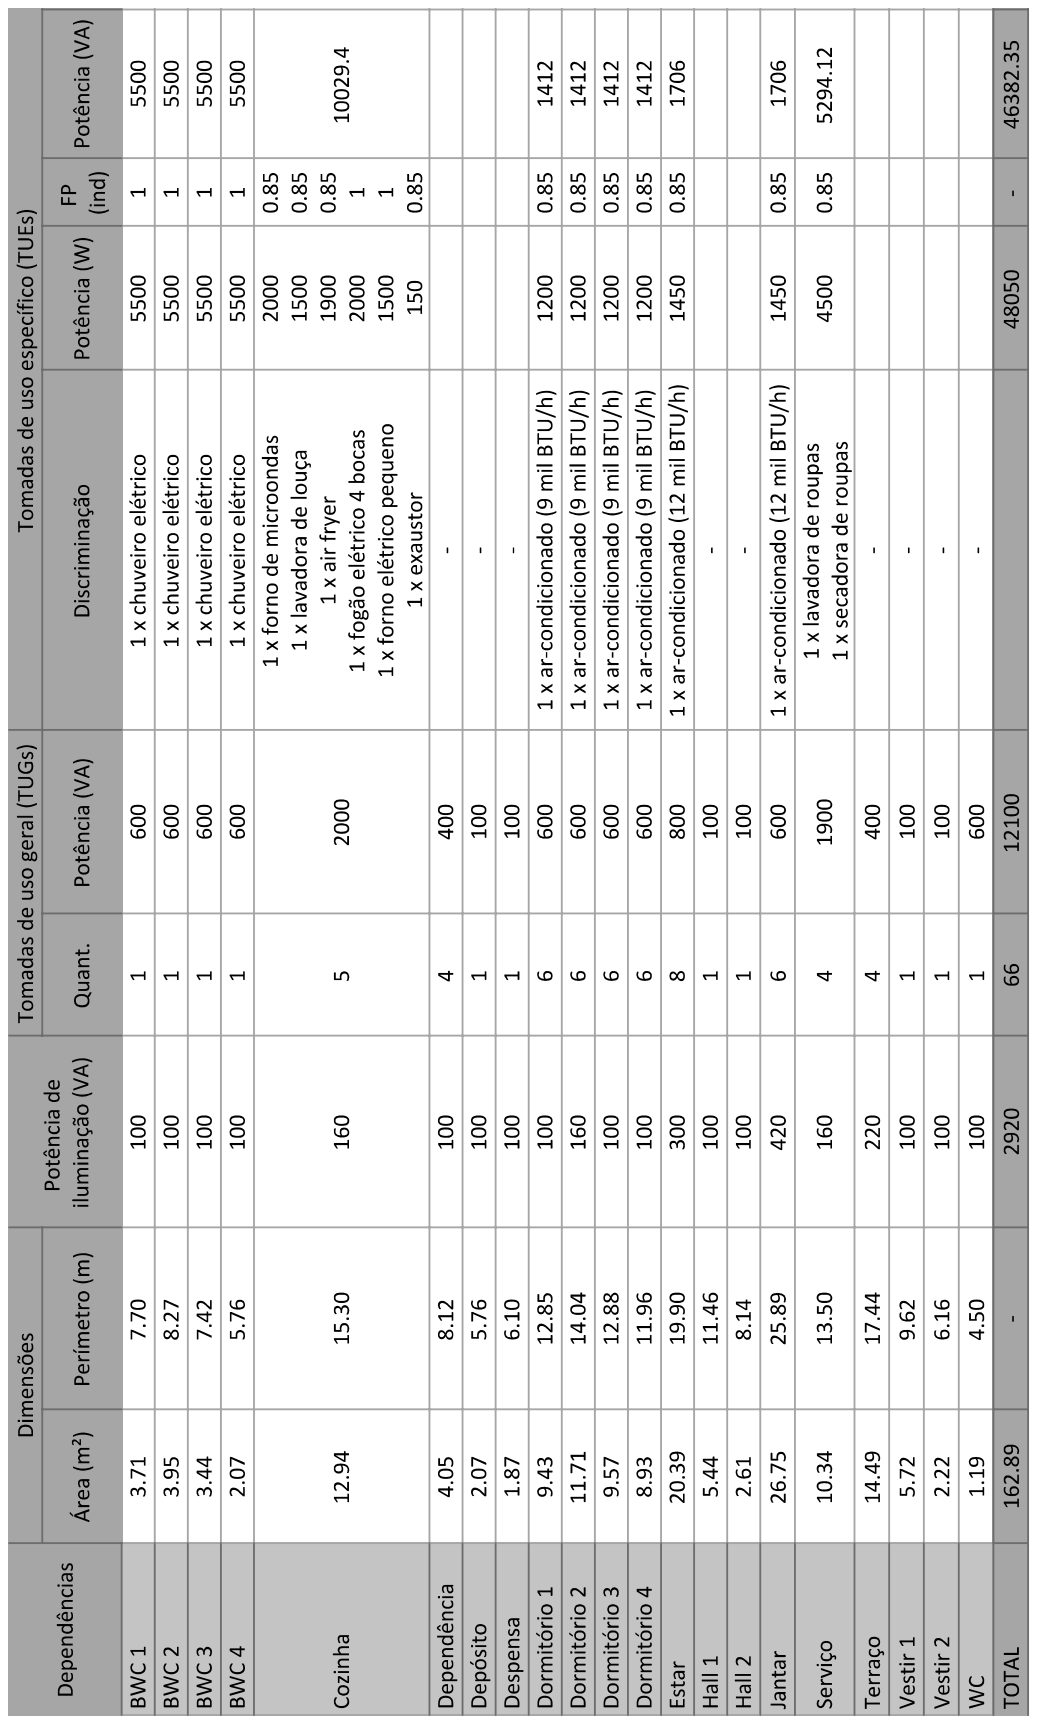
[picture p14: page 1]
