Lwao/projeto-instalacoes-eletrica/exportacao/Anexos/Diagramas unifilares/QF-CM.pdf

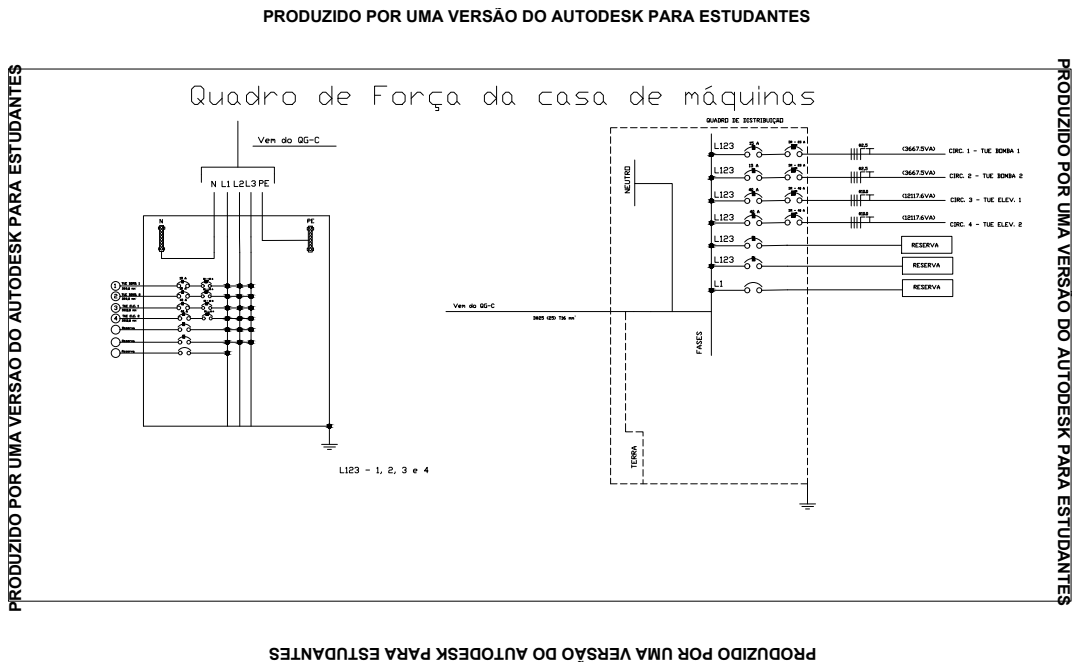
[picture p15: page 1]

PRODUZIDO POR UMA VERSÃO DO AUTODESK PARA ESTUDANTES
