Lwao/projeto-instalacoes-eletrica/exportacao/Anexos/Diagramas unifilares/QG-C.pdf

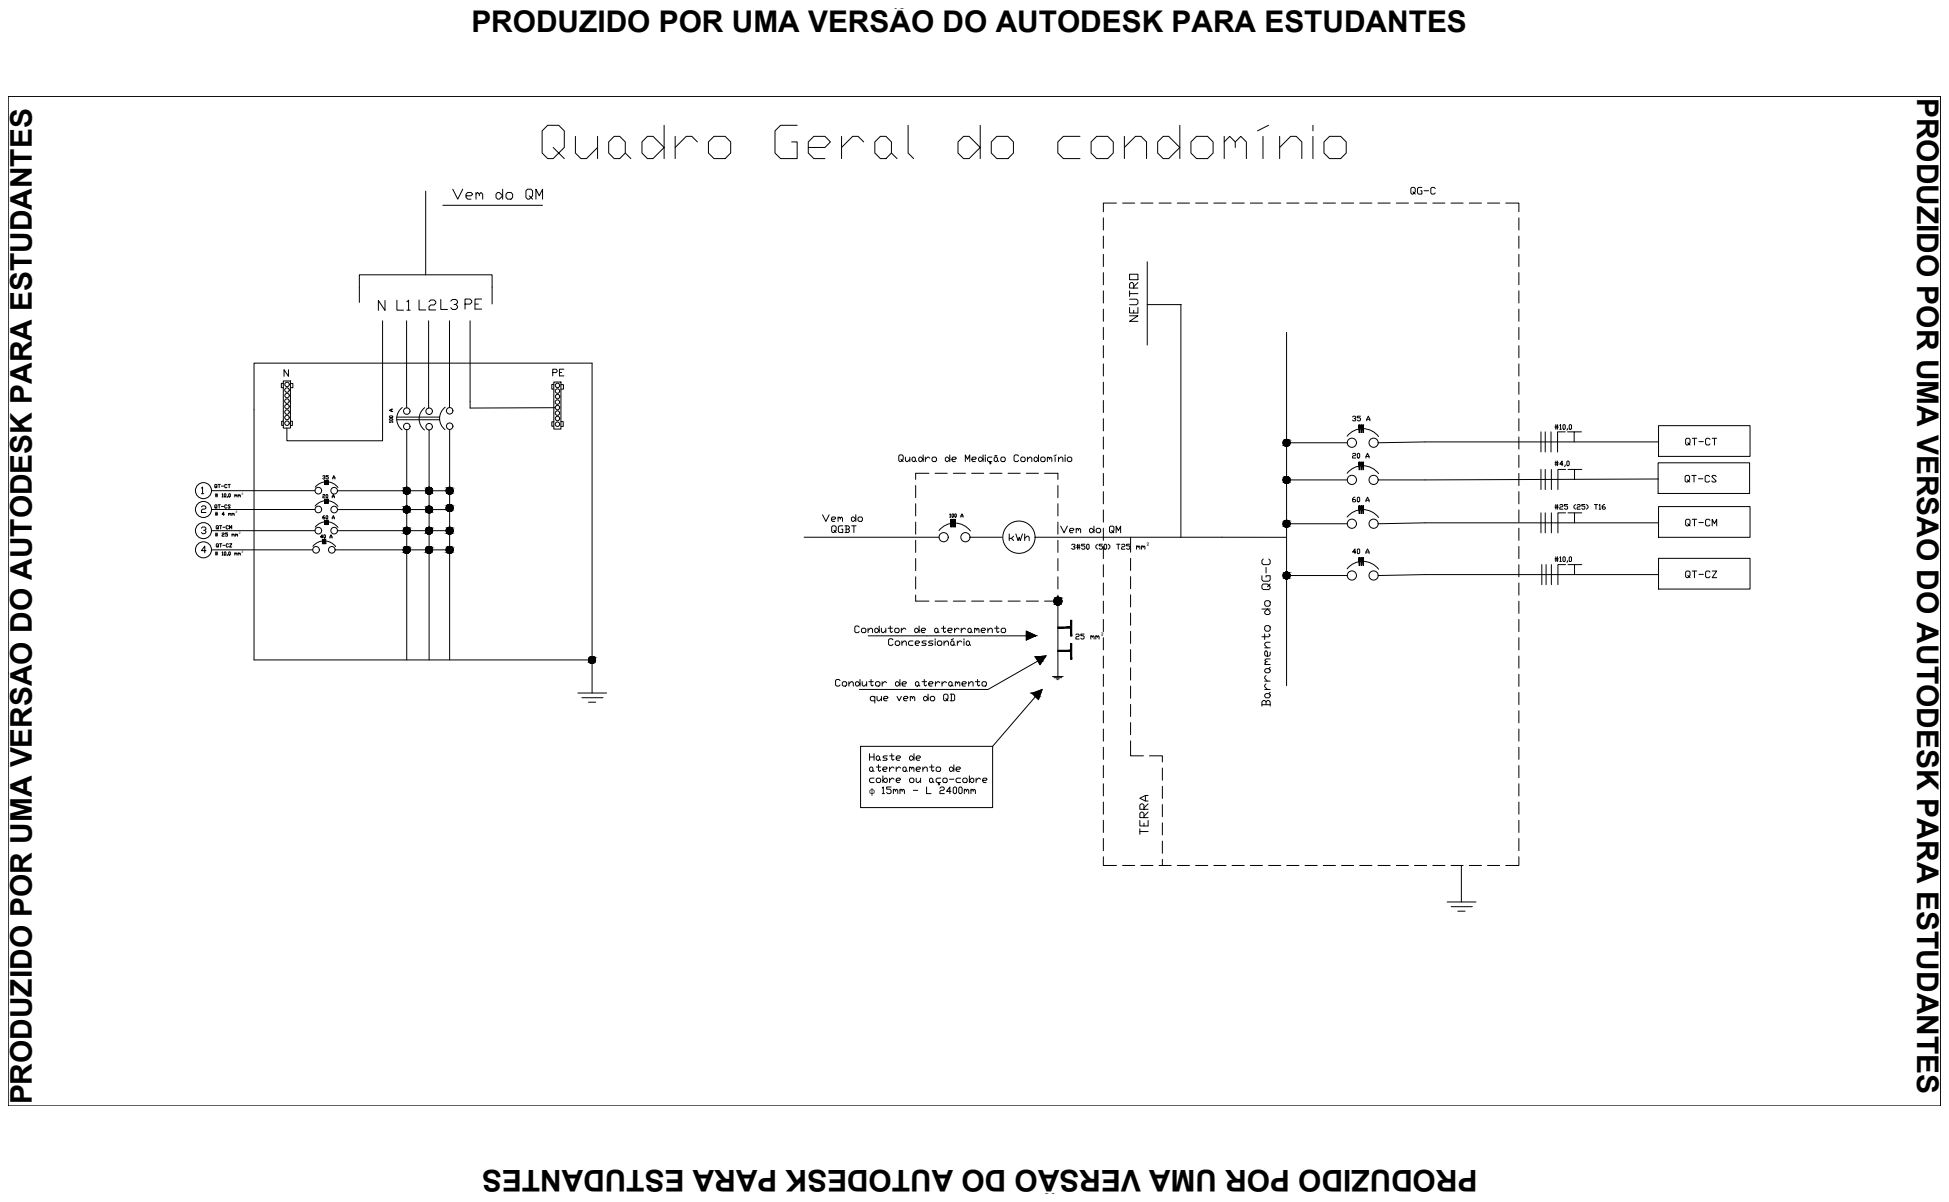
[picture p16: page 1]

PRODUZIDO POR UMA VERSÃO DO AUTODESK PARA ESTUDANTES
