Lwao/projeto-instalacoes-eletrica/exportacao/Anexos/Diagramas unifilares/QGBT.pdf

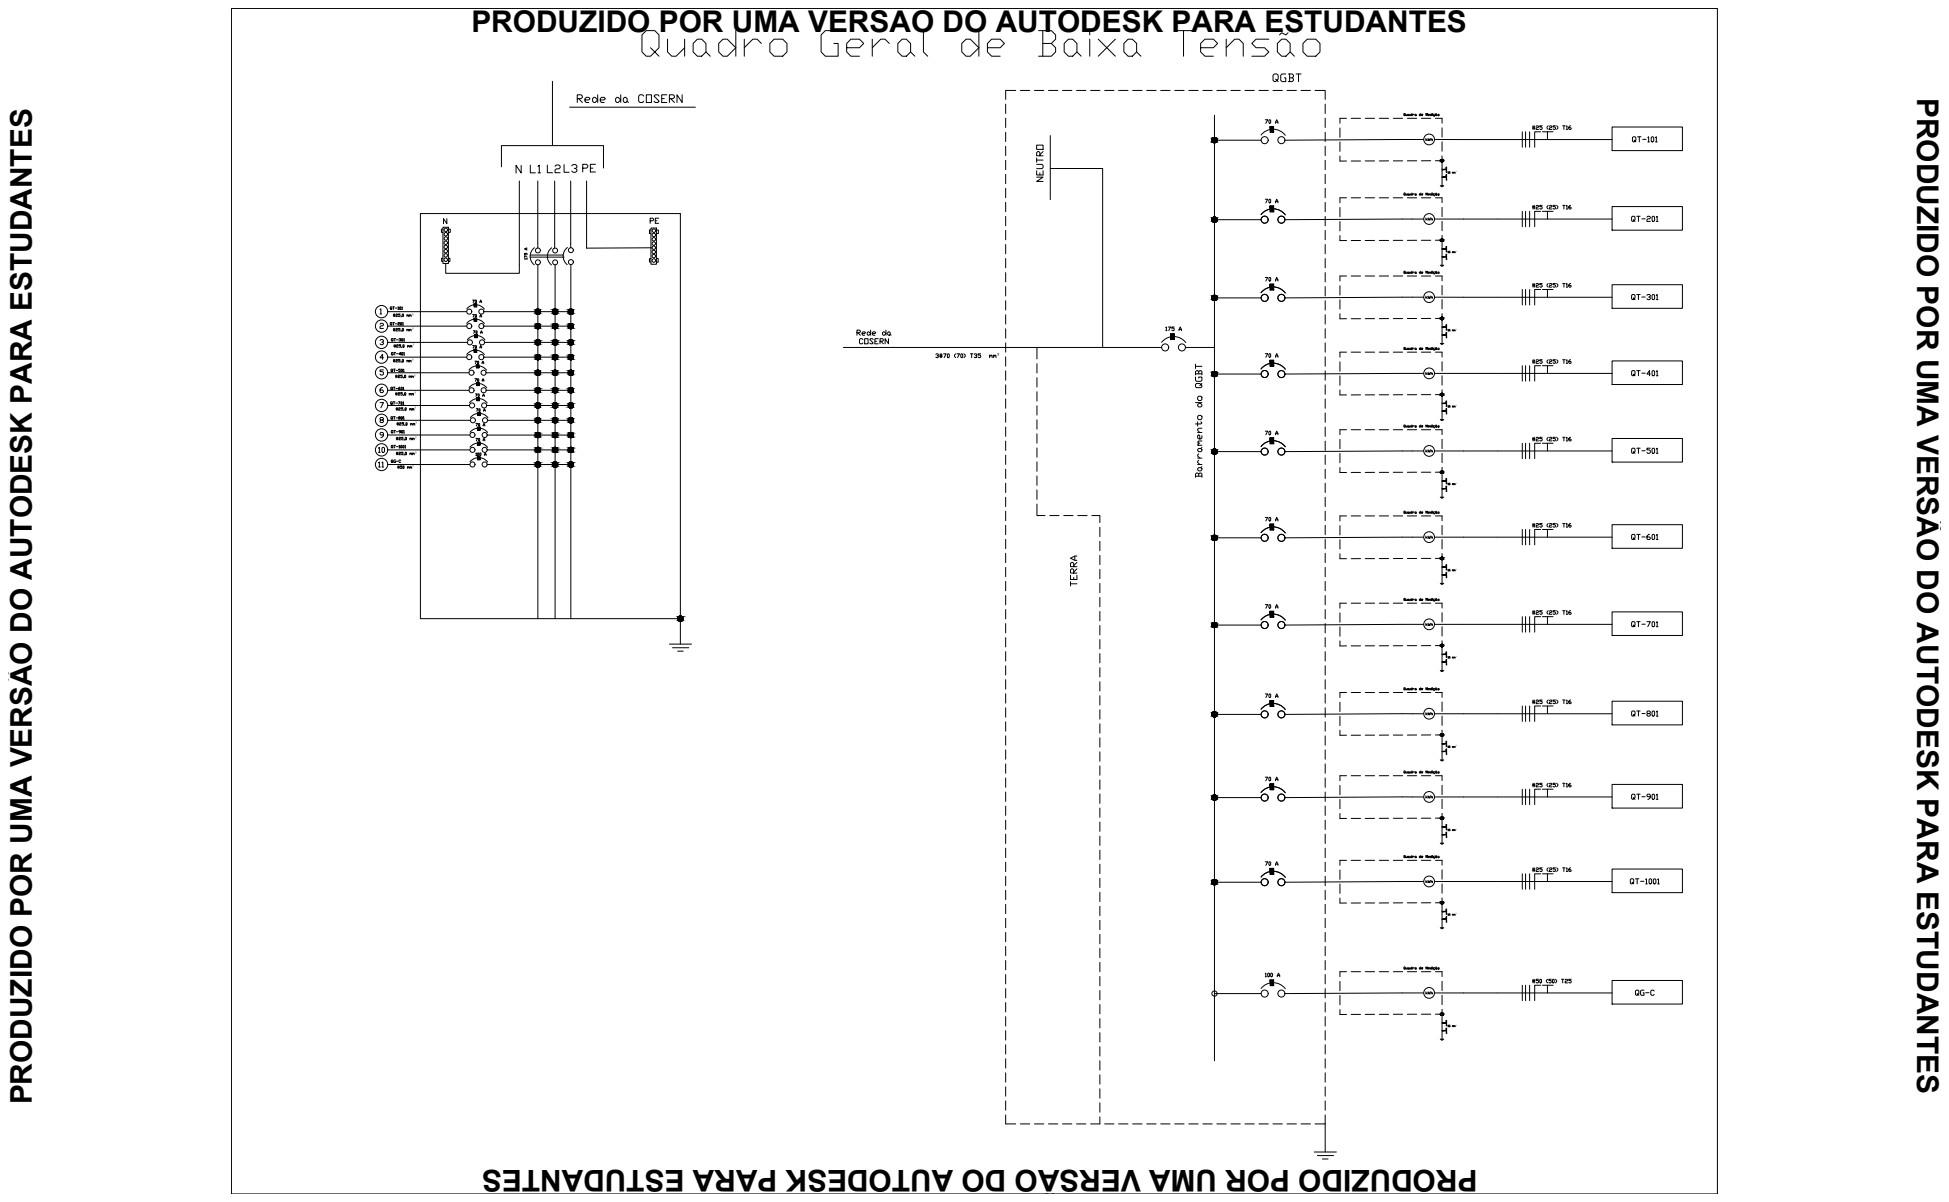
[picture p17: page 1]
²²²²²²²²²²² ²²²²²²²²²

PRODUZIDO POR UMA VERSÃO DO AUTODESK PARA ESTUDANTES
