Lwao/projeto-instalacoes-eletrica/exportacao/Anexos/Diagramas unifilares/QT-CS.pdf

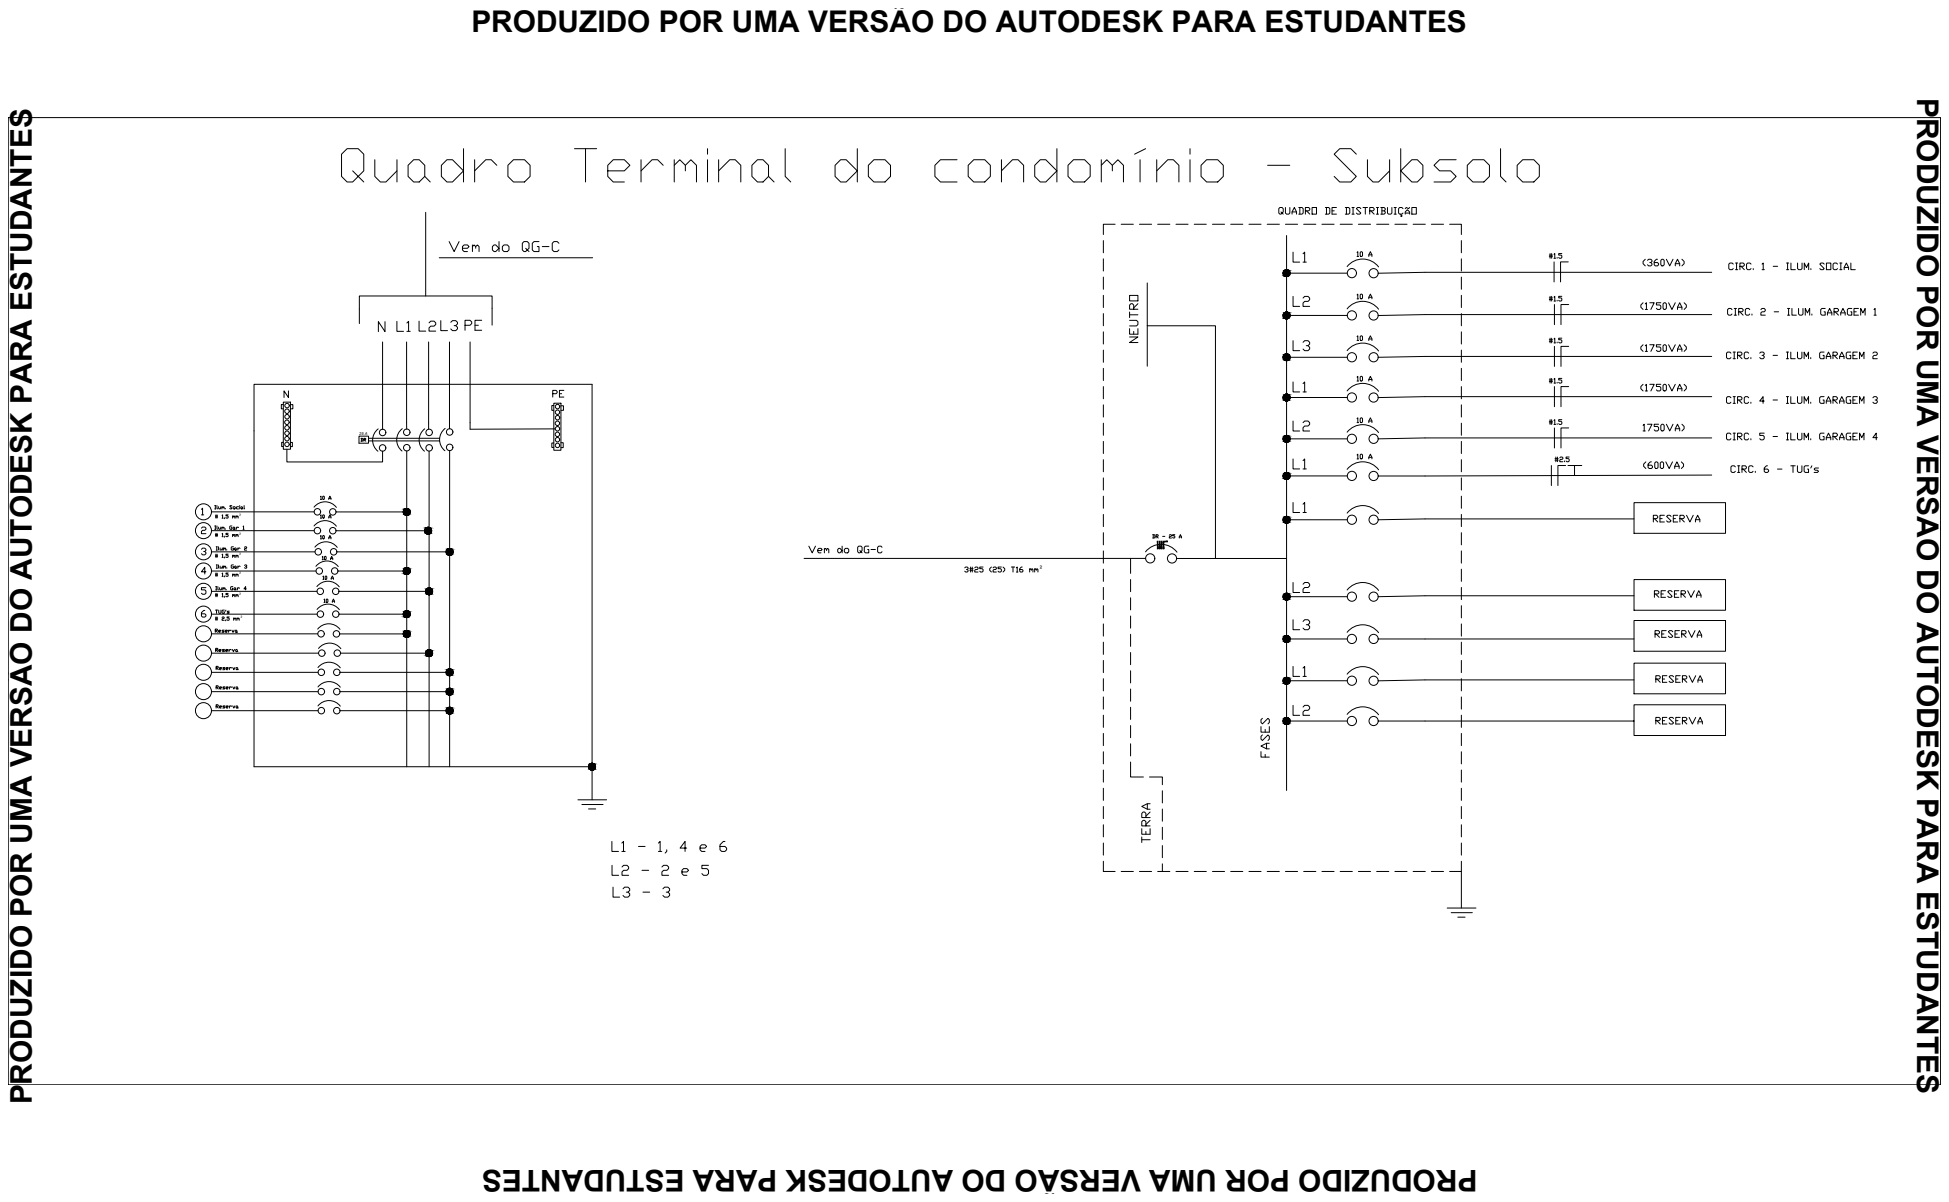
[picture p18: page 1]
25 A ²²²²²²

PRODUZIDO POR UMA VERSÃO DO AUTODESK PARA ESTUDANTES
