Lwao/projeto-instalacoes-eletrica/exportacao/Anexos/Diagramas unifilares/QT-CT.pdf

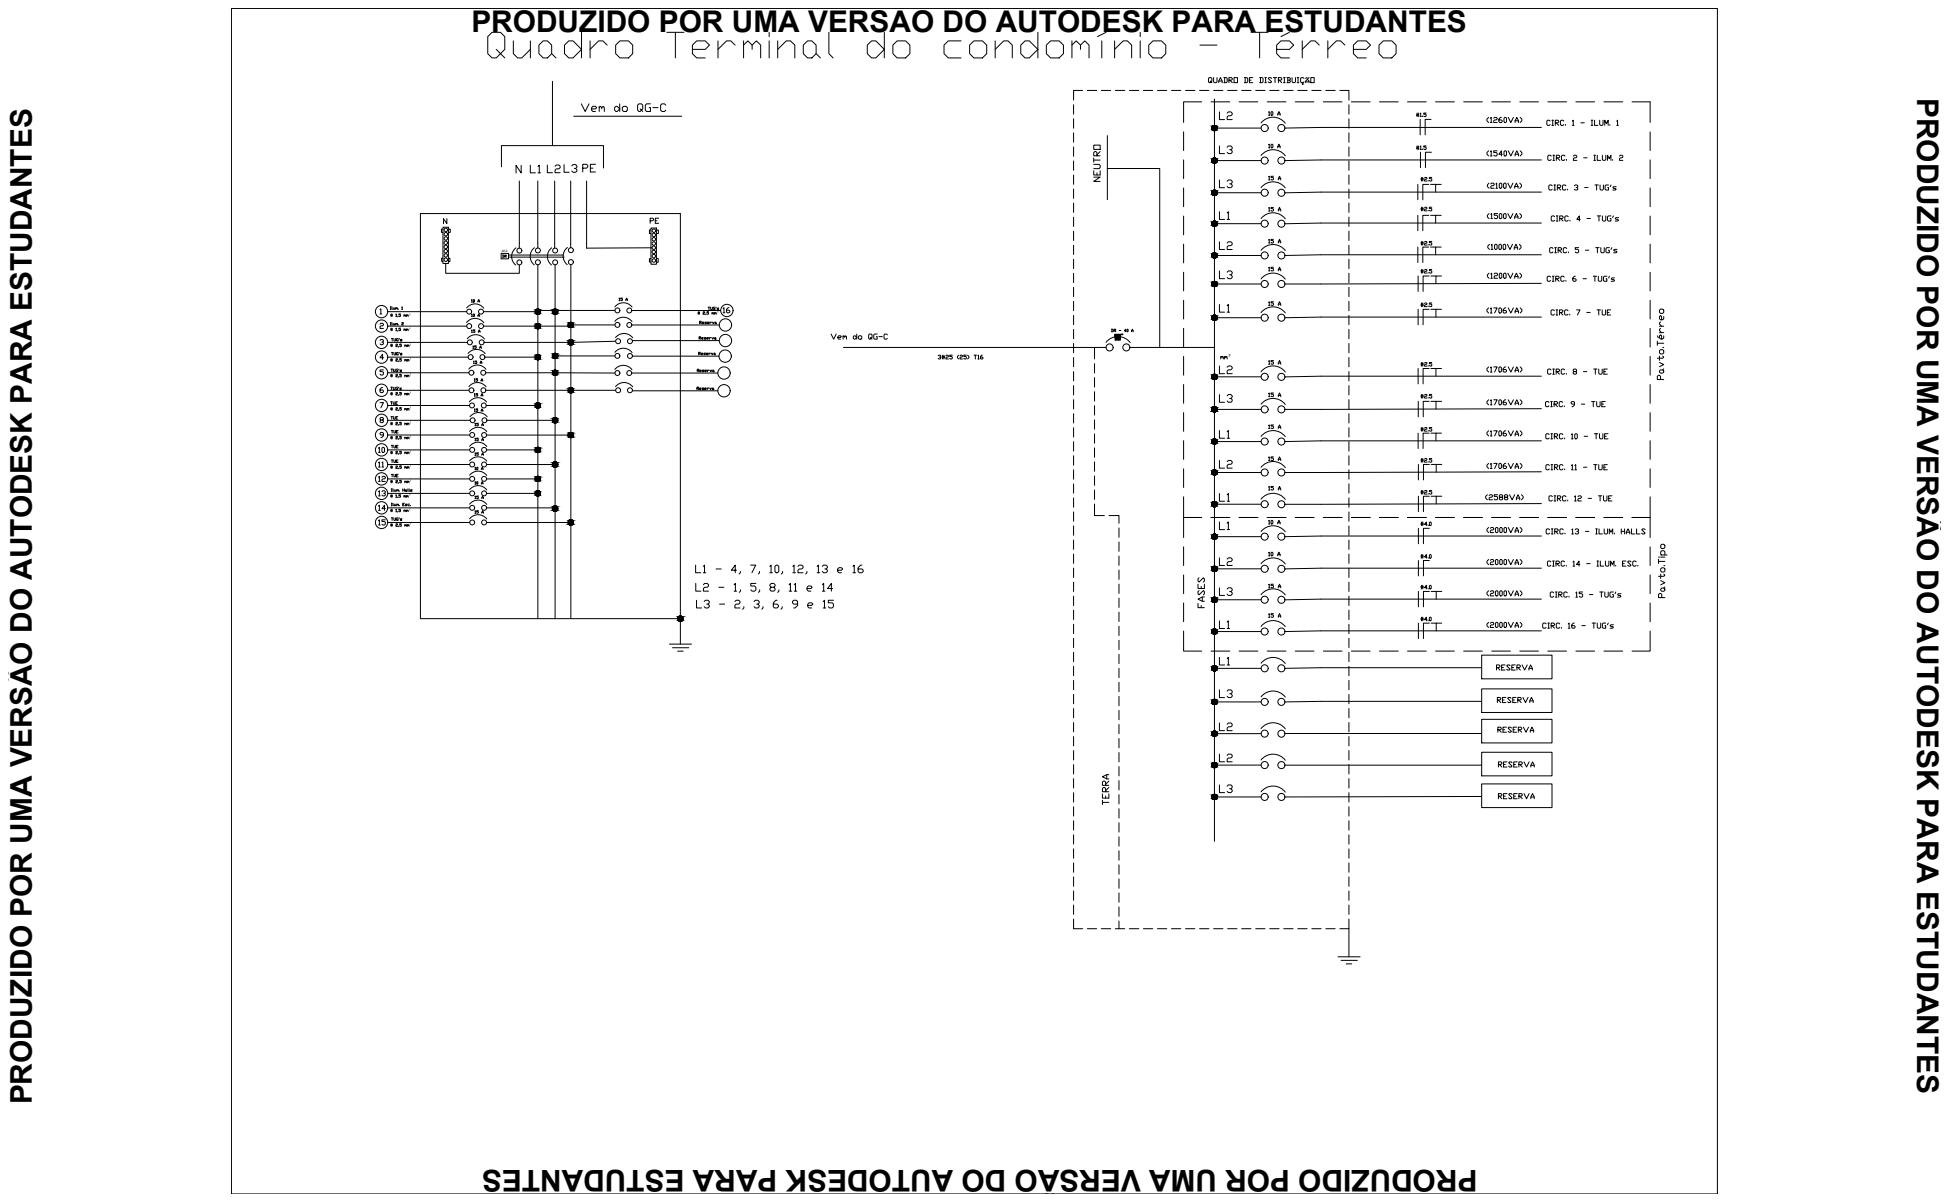
[picture p19: page 1]
40 A ²²²²²²²²²; ² ²²²²²²

PRODUZIDO POR UMA VERSÃO DO AUTODESK PARA ESTUDANTES
