Lwao/projeto-instalacoes-eletrica/exportacao/Anexos/Diagramas unifilares/QT-CZ.pdf

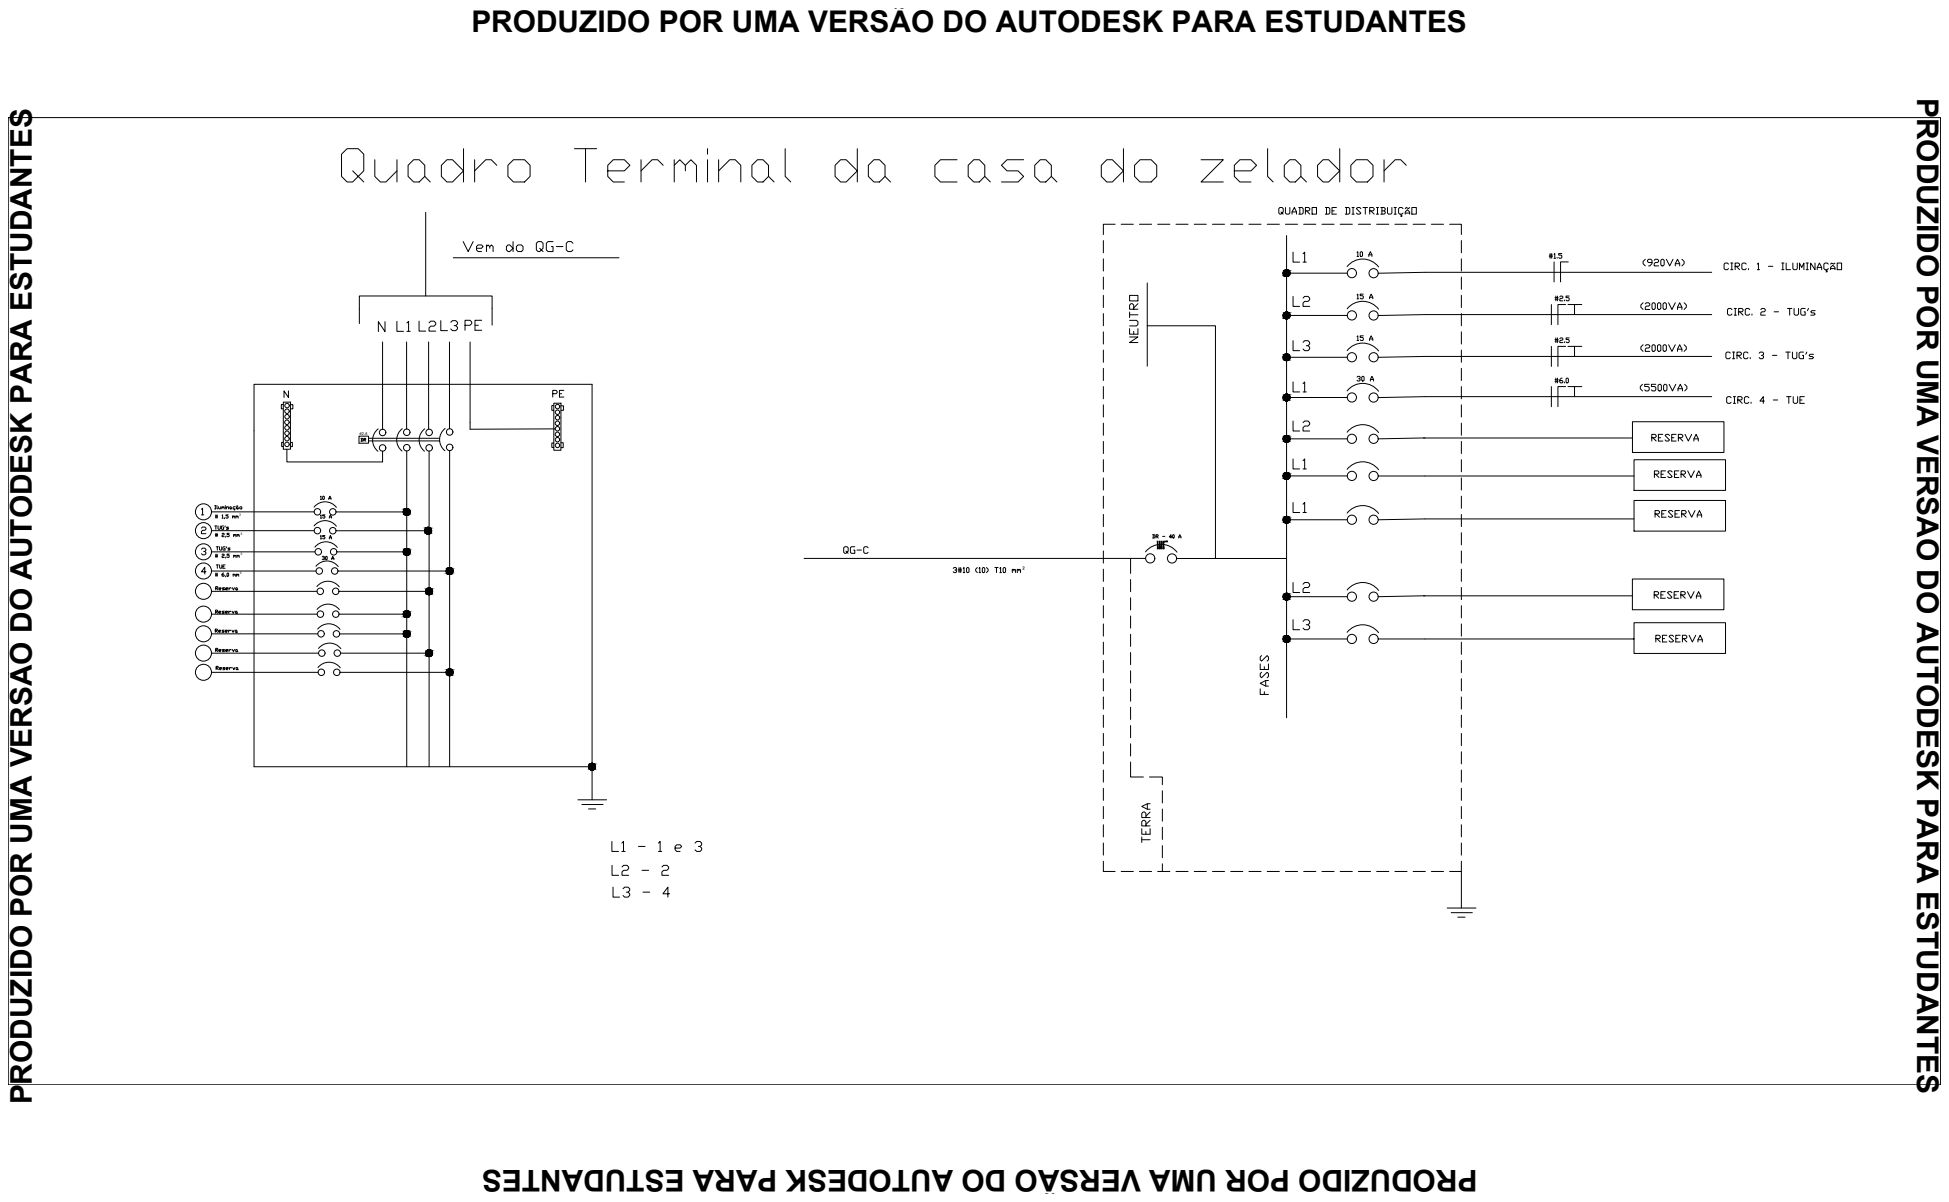
[picture p20: page 1]
40 A ²²²²

PRODUZIDO POR UMA VERSÃO DO AUTODESK PARA ESTUDANTES
