Lwao/projeto-instalacoes-eletrica/exportacao/Anexos/Diagramas unifilares/QT-X01.pdf

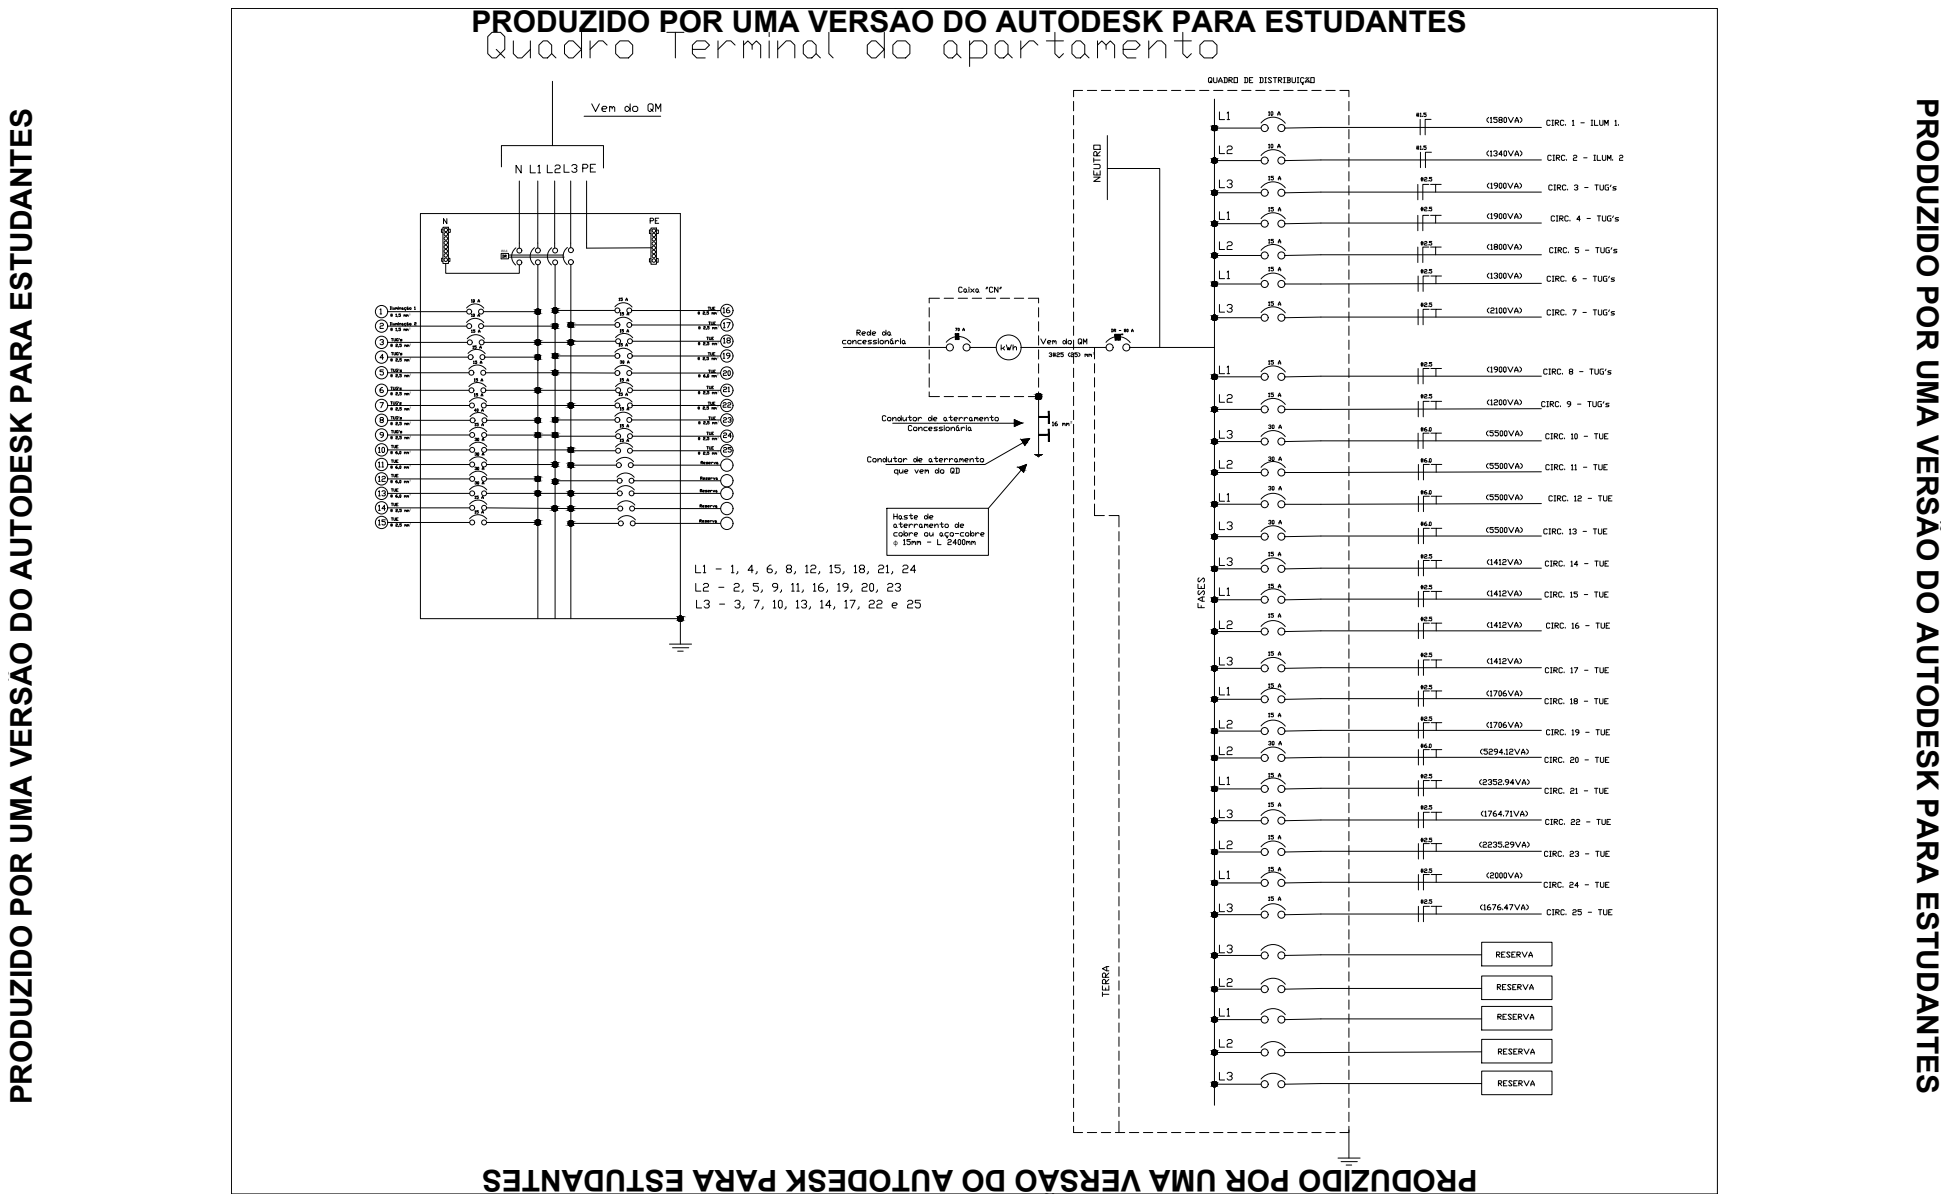
[picture p21: page 1]
80 A ²²²²²²²²²; ²²²; ² ²²²²²²; ²²²²²²²

PRODUZIDO POR UMA VERSÃO DO AUTODESK PARA ESTUDANTES
