Lwao/projeto-instalacoes-eletrica/exportacao/Anexos/Outros/aterramento.pdf

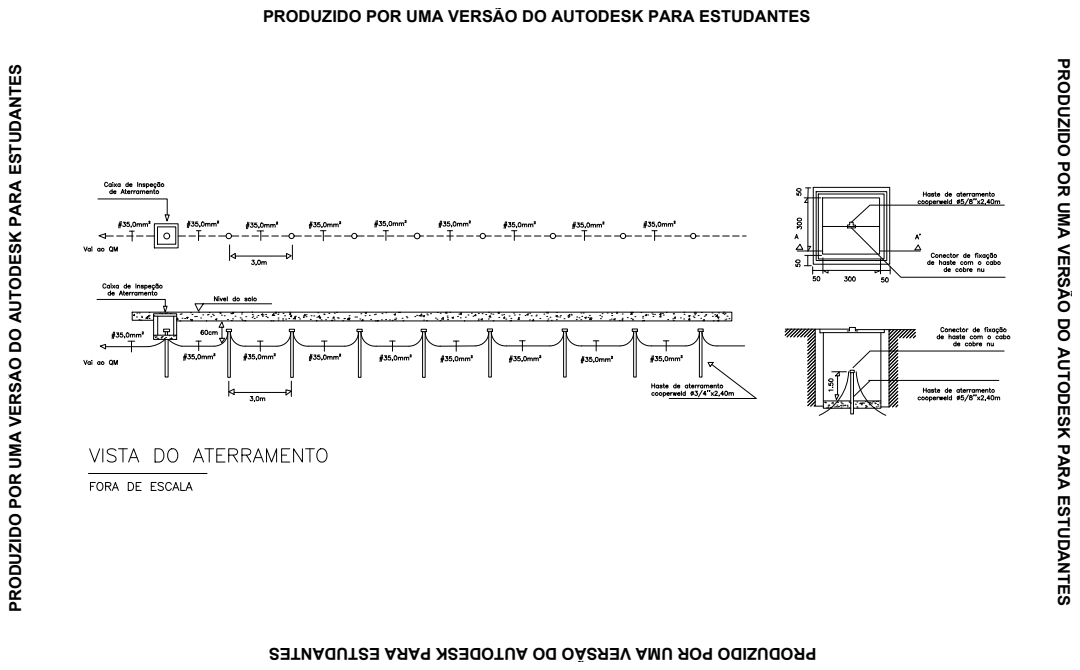
[picture p22: page 1]

PRODUZIDO POR UMA VERSÃO DO AUTODESK PARA ESTUDANTES
