Lwao/projeto-instalacoes-eletrica/exportacao/Anexos/Outros/medicao.pdf

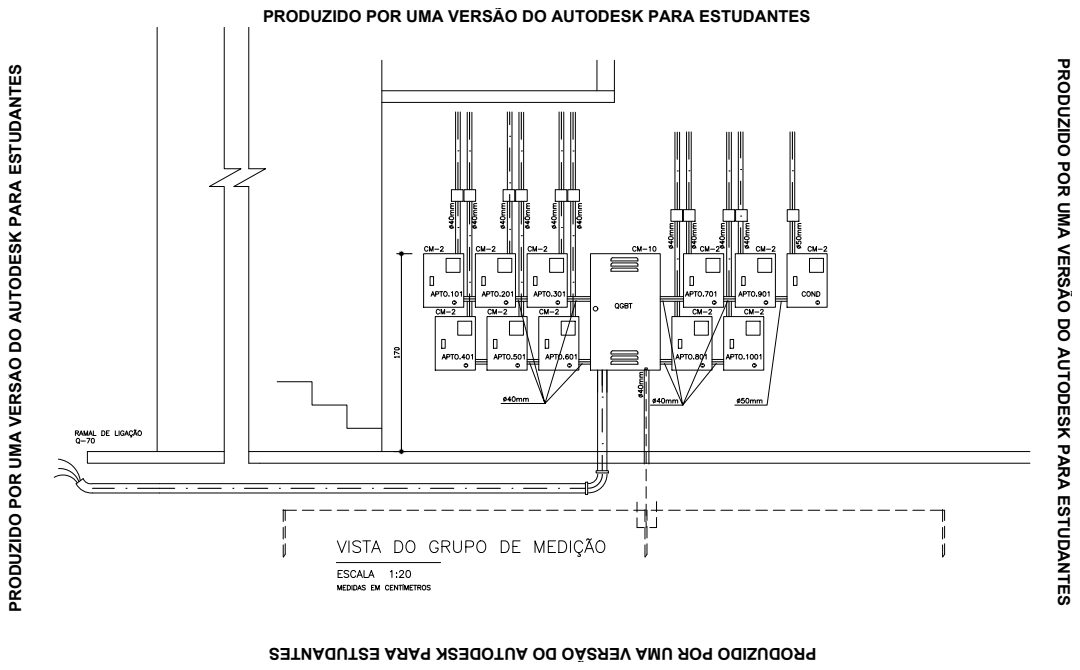
[picture p23: page 1]

PRODUZIDO POR UMA VERSÃO DO AUTODESK PARA ESTUDANTES
