Lwao/projeto-instalacoes-eletrica/exportacao/Anexos/Outros/prumada.pdf

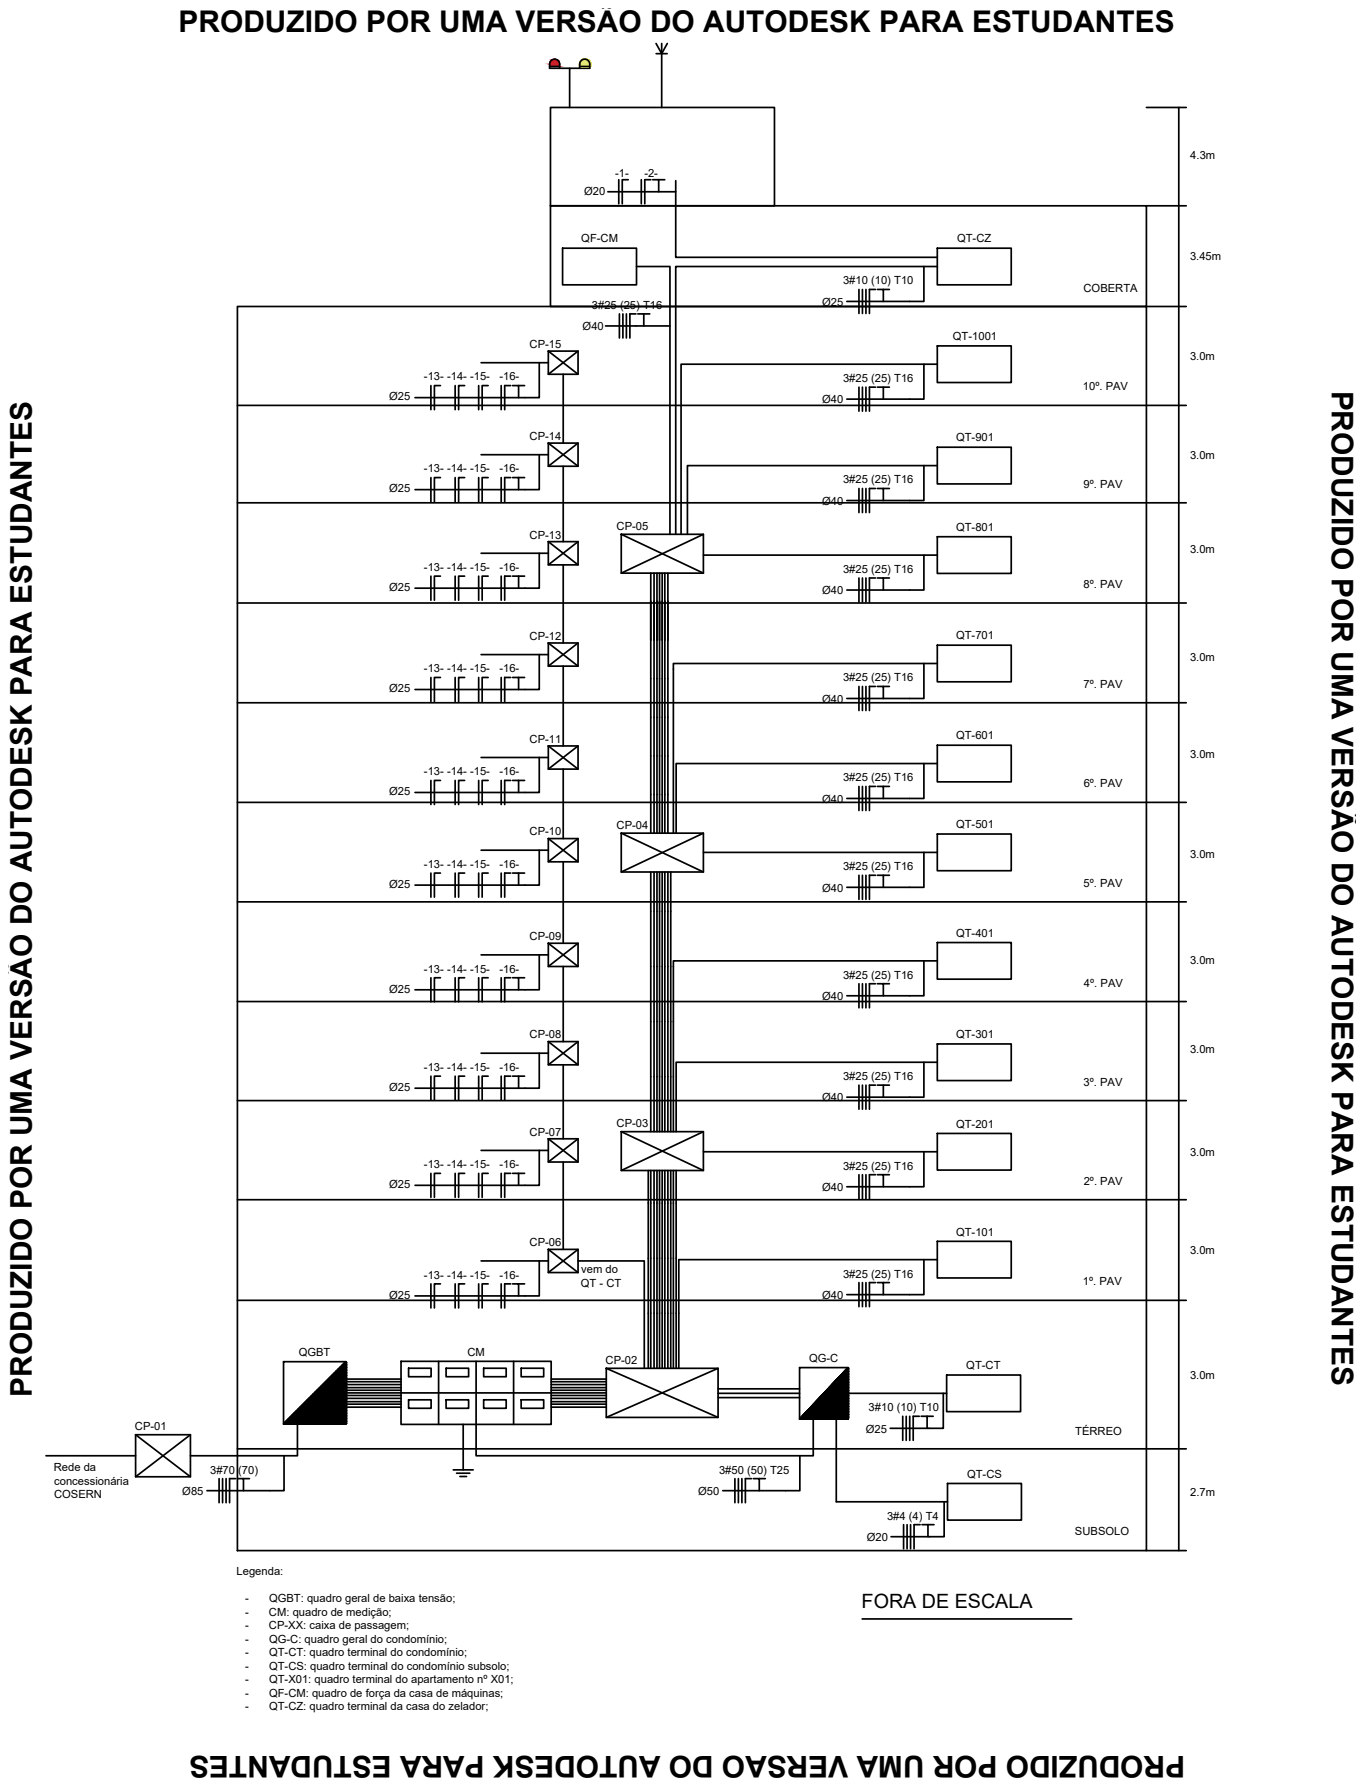
[picture p24: page 1]
vem do QT - CT Ø25; 1º. PAV; 2º. PAV; 3º. PAV; 4º. PAV; 5º. PAV; 6º. PAV; 7º. PAV; 8º. PAV; 9º. PAV; 10º. PAV COBERTA; QGBT; Rede da concessionária COSERN; Legenda: -; QGBT: quadro geral de baixa tensão; -; CM: quadro de medição; -; CP-XX: caixa de passagem; -; QG-C: quadro geral do condomínio; -; QT-CT: quadro terminal do condomínio; -; QT-CS: quadro terminal do condomínio subsolo; -; QT-X01: quadro terminal do apartamento nº X01; -; QF-CM: quadro de força da casa de máquinas; -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

PRODUZIDO POR UMA VERSÃO DO AUTODESK PARA ESTUDANTES

FORA DE ESCALA
