Lwao/projeto-instalacoes-eletrica/exportacao/Anexos/Outros/spda.pdf

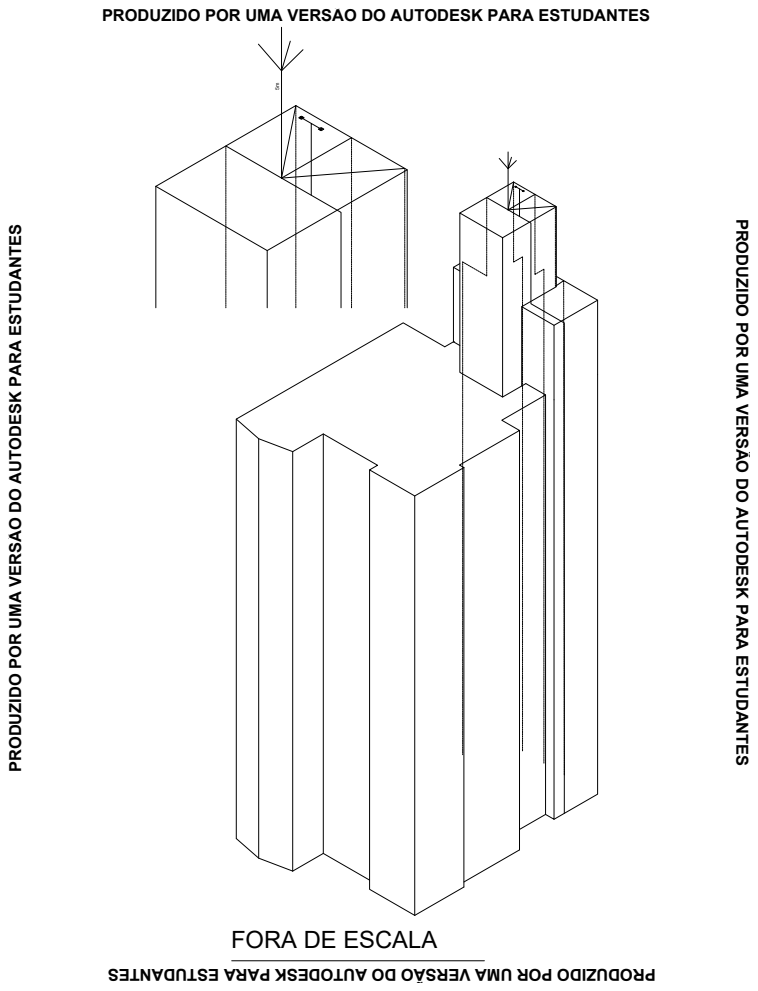
[picture p25: page 1]

PRODUZIDO POR UMA VERSÃO DO AUTODESK PARA ESTUDANTES

FORA DE ESCALA
