Lwao/projeto-instalacoes-eletrica/exportacao/Anexos/Plantas baixas/legenda.pdf

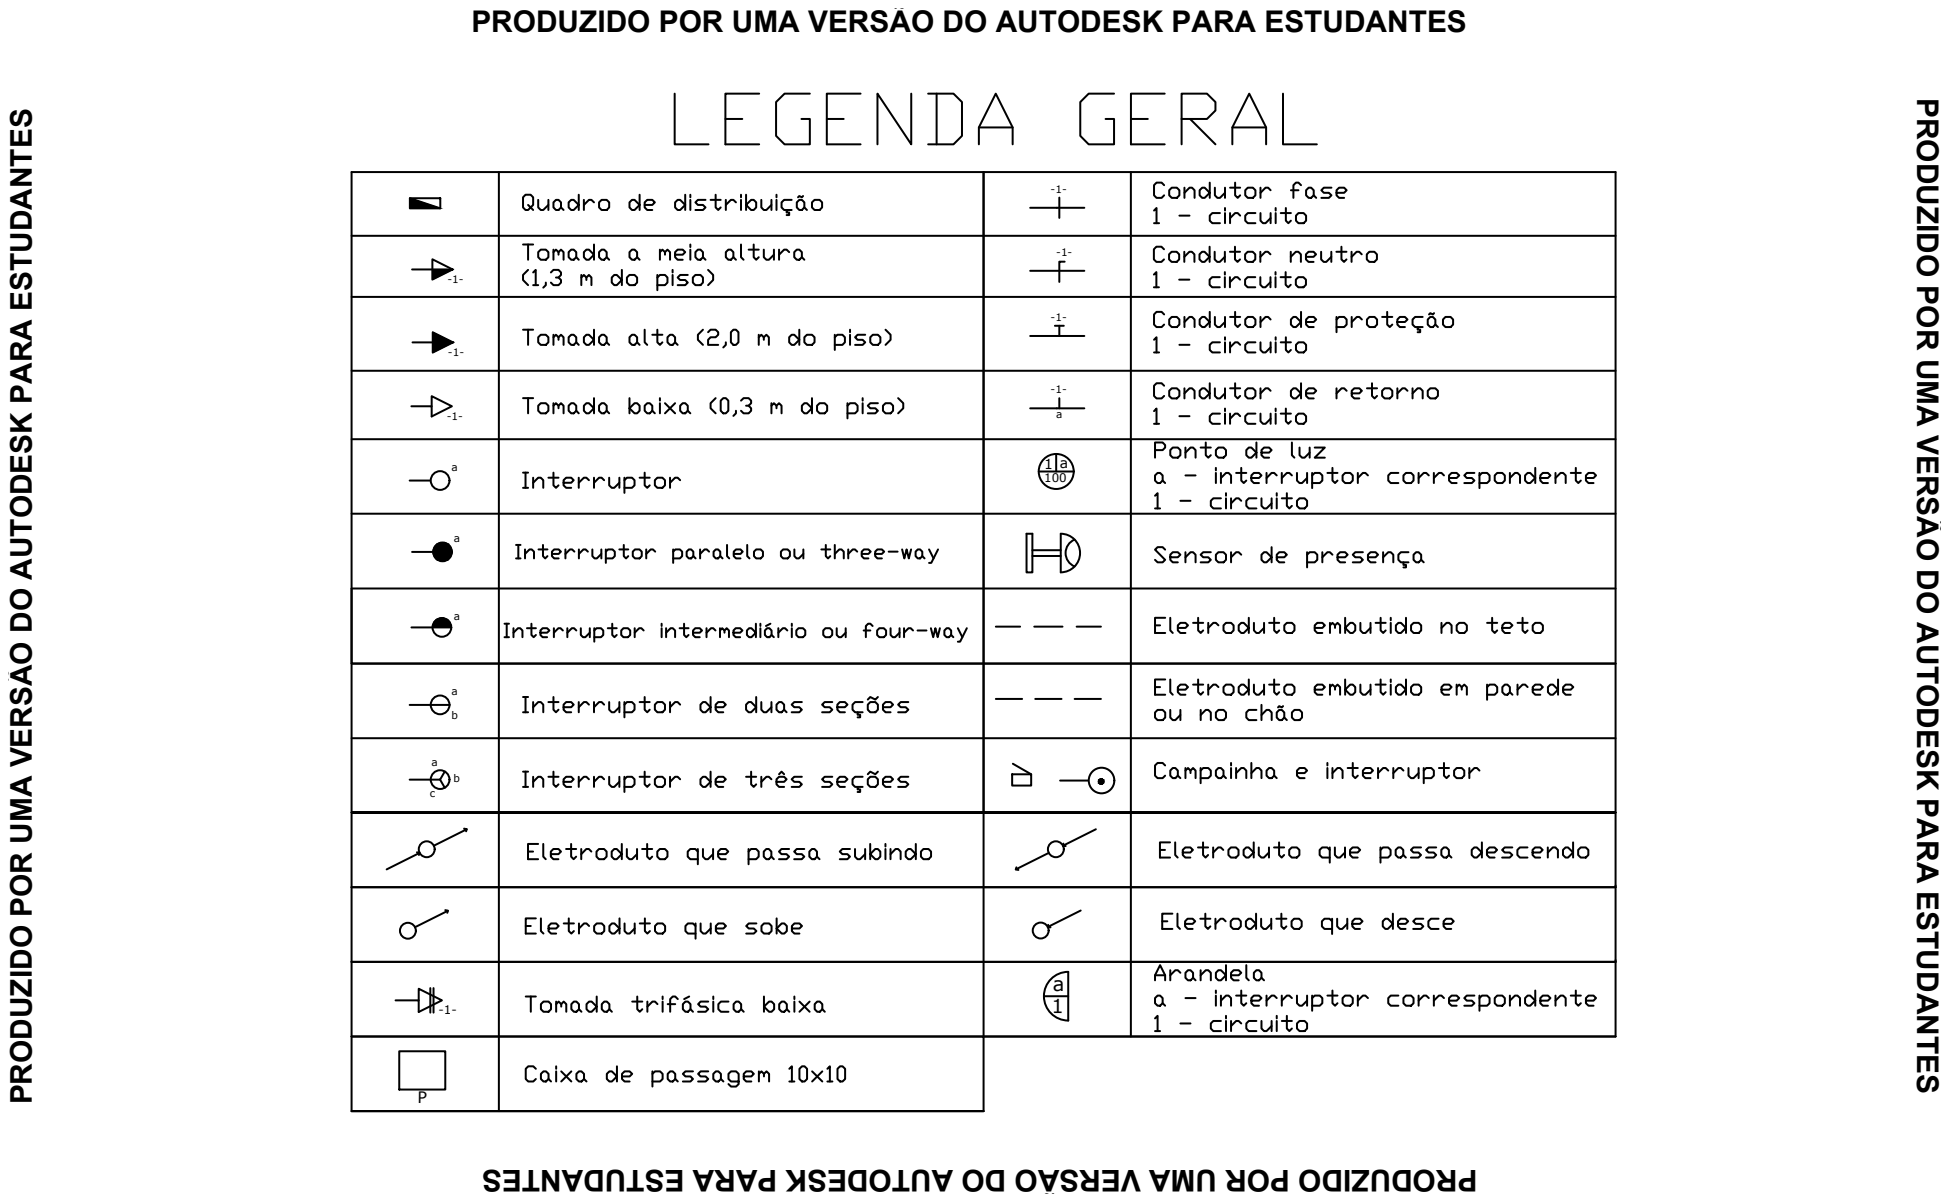
[picture p26: page 1]
-1- aaabb ac a

PRODUZIDO POR UMA VERSÃO DO AUTODESK PARA ESTUDANTES
