Lwao/projeto-instalacoes-eletrica/exportacao/Anexos/Plantas baixas/planta_externa.pdf

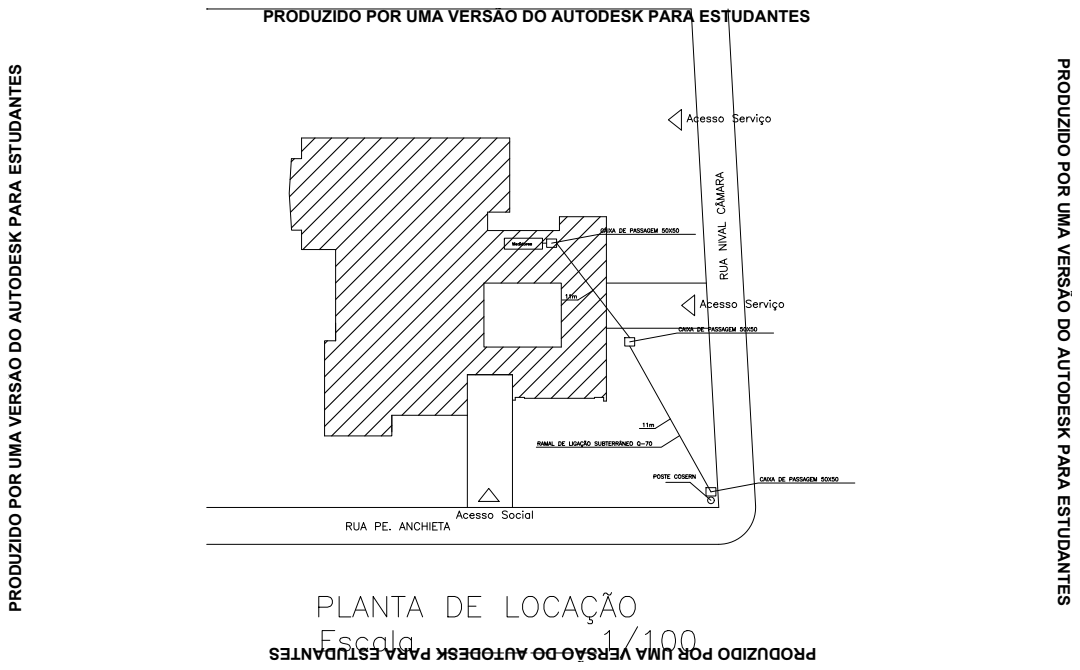
[picture p27: page 1]

PRODUZIDO POR UMA VERSÃO DO AUTODESK PARA ESTUDANTES
