Lwao/projeto-instalacoes-eletrica/exportacao/Anexos/Plantas baixas/planta_pavimento.pdf

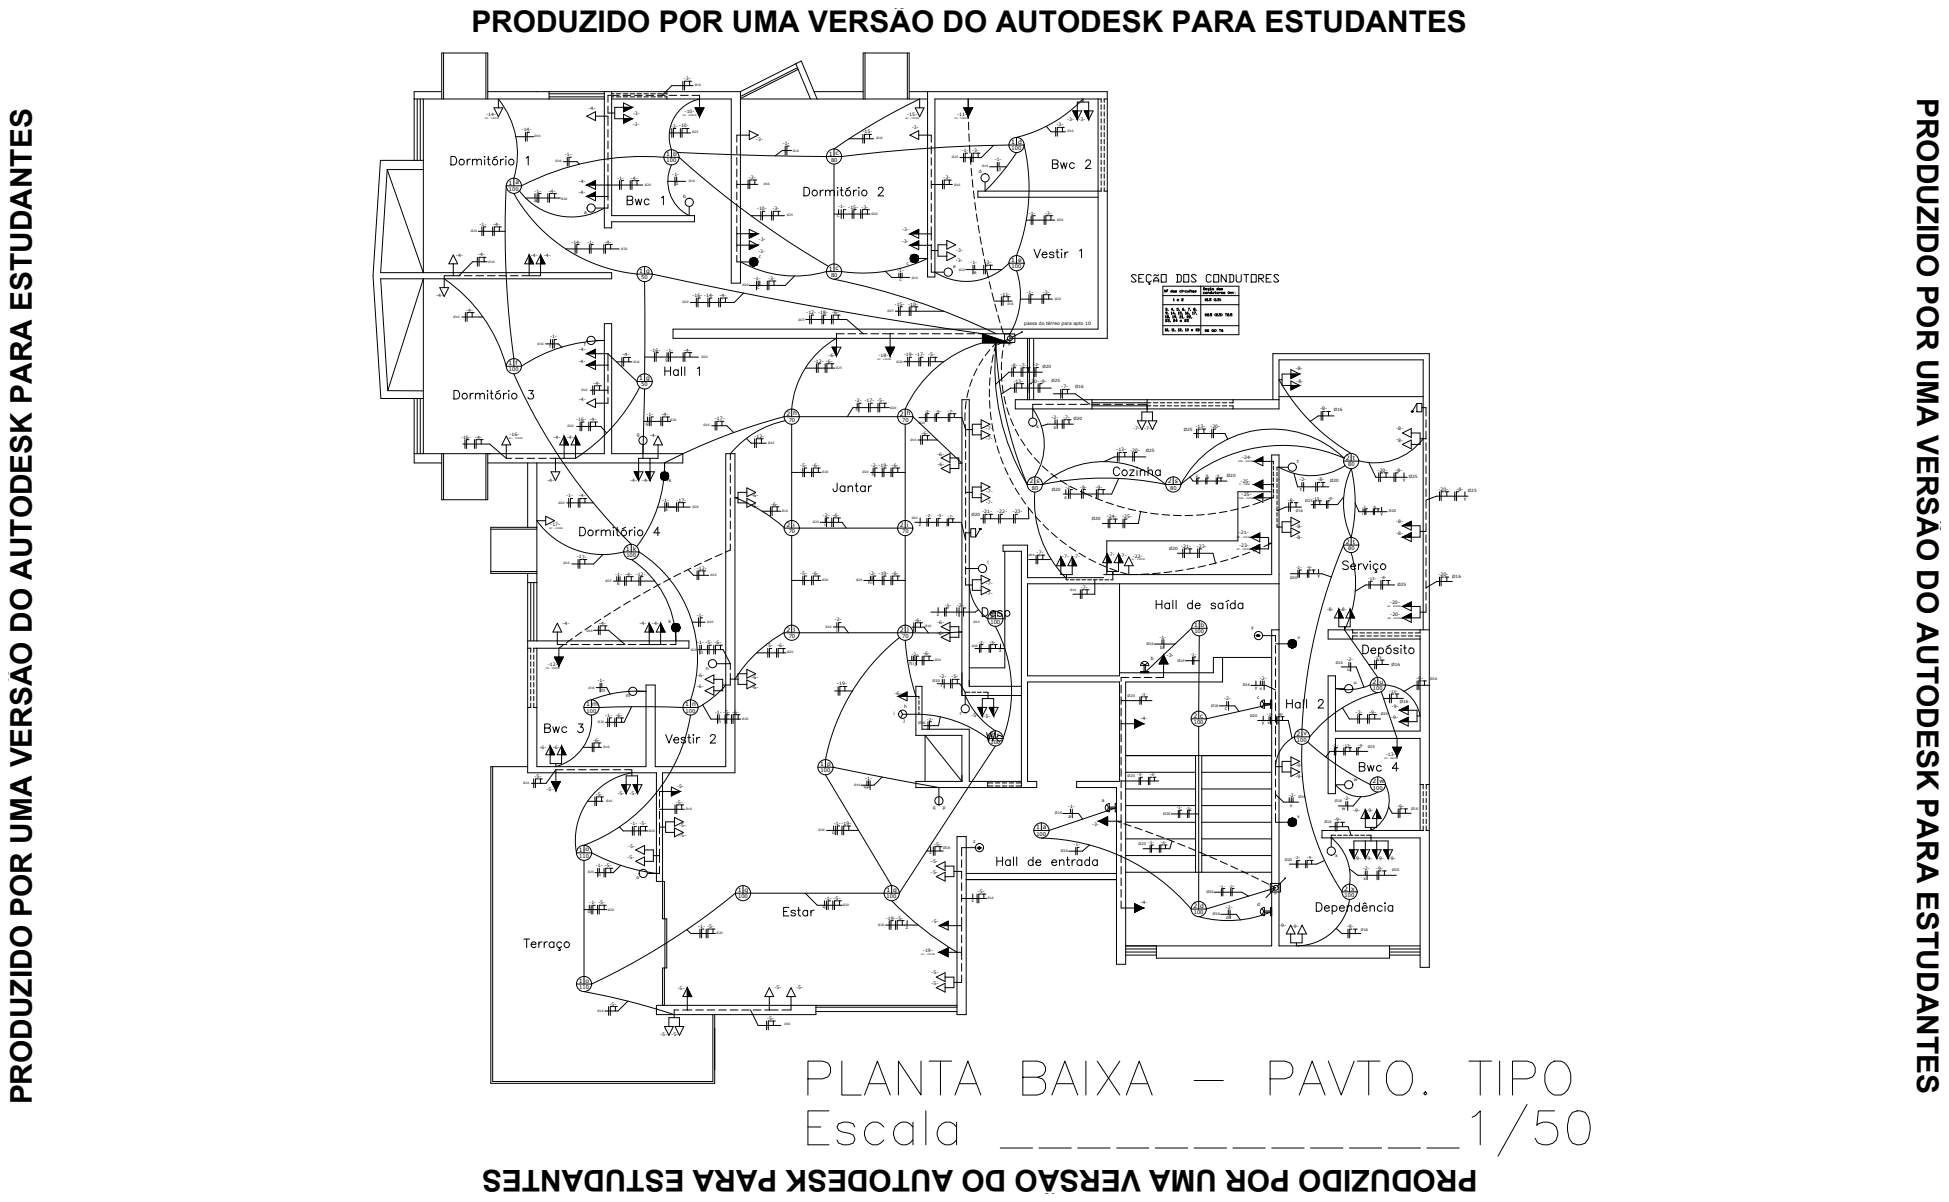
[picture p28: page 1]
FOR - 1500W; FOG - 6000W; -2- -6- hij; passa do térreo para apto 10; P P PRODUZIDO POR UMA VERSÃO DO AUTODESK PARA ESTUDANTES PRODUZIDO POR UMA VERSÃO DO AUTODESK PARA ESTUDANTES
