Lwao/projeto-instalacoes-eletrica/exportacao/Anexos/Plantas baixas/planta_subsolo.pdf

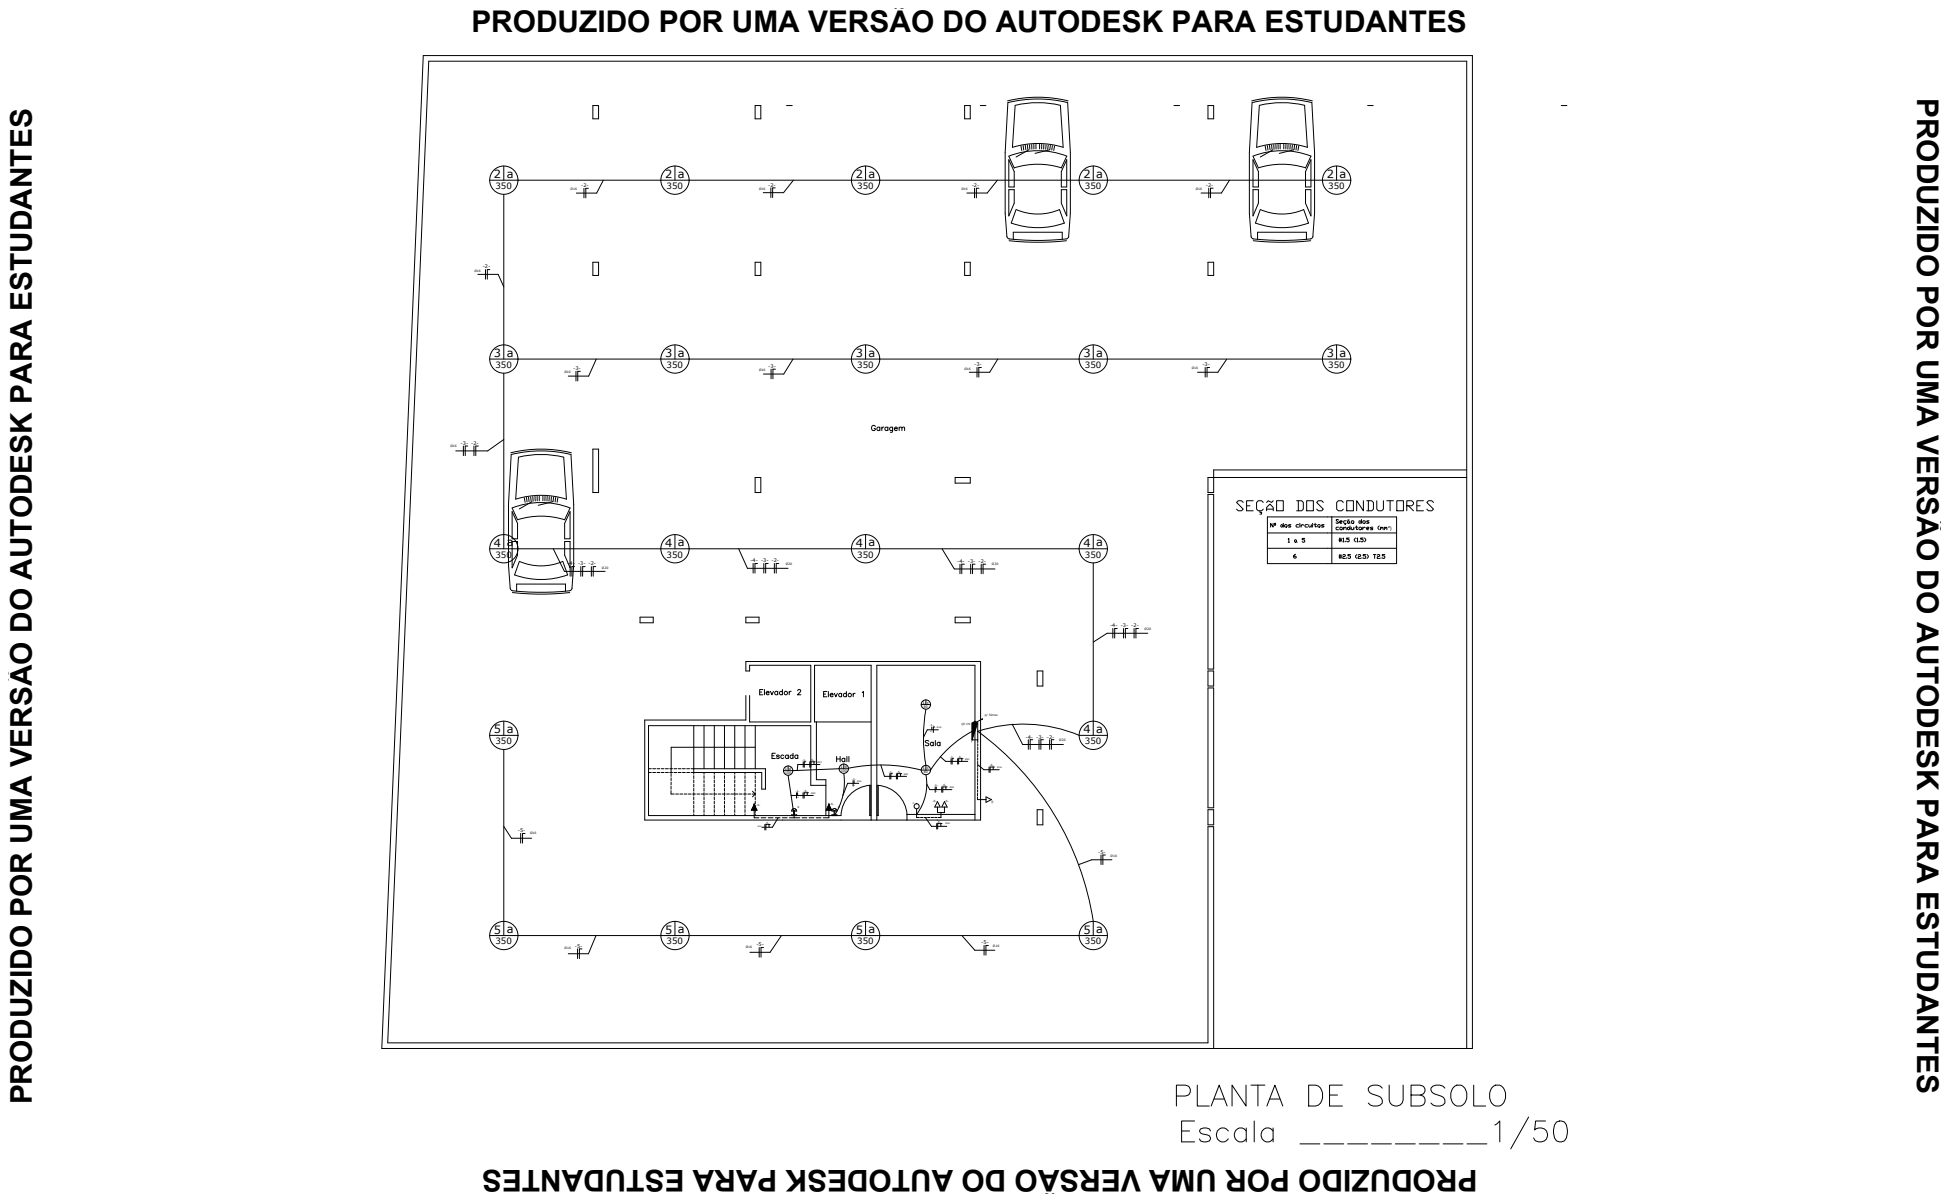
[picture p29: page 1]

PRODUZIDO POR UMA VERSÃO DO AUTODESK PARA ESTUDANTES

p/ Térreo QT-CS
