Lwao/projeto-instalacoes-eletrica/exportacao/Anexos/Plantas baixas/planta_zelador.pdf

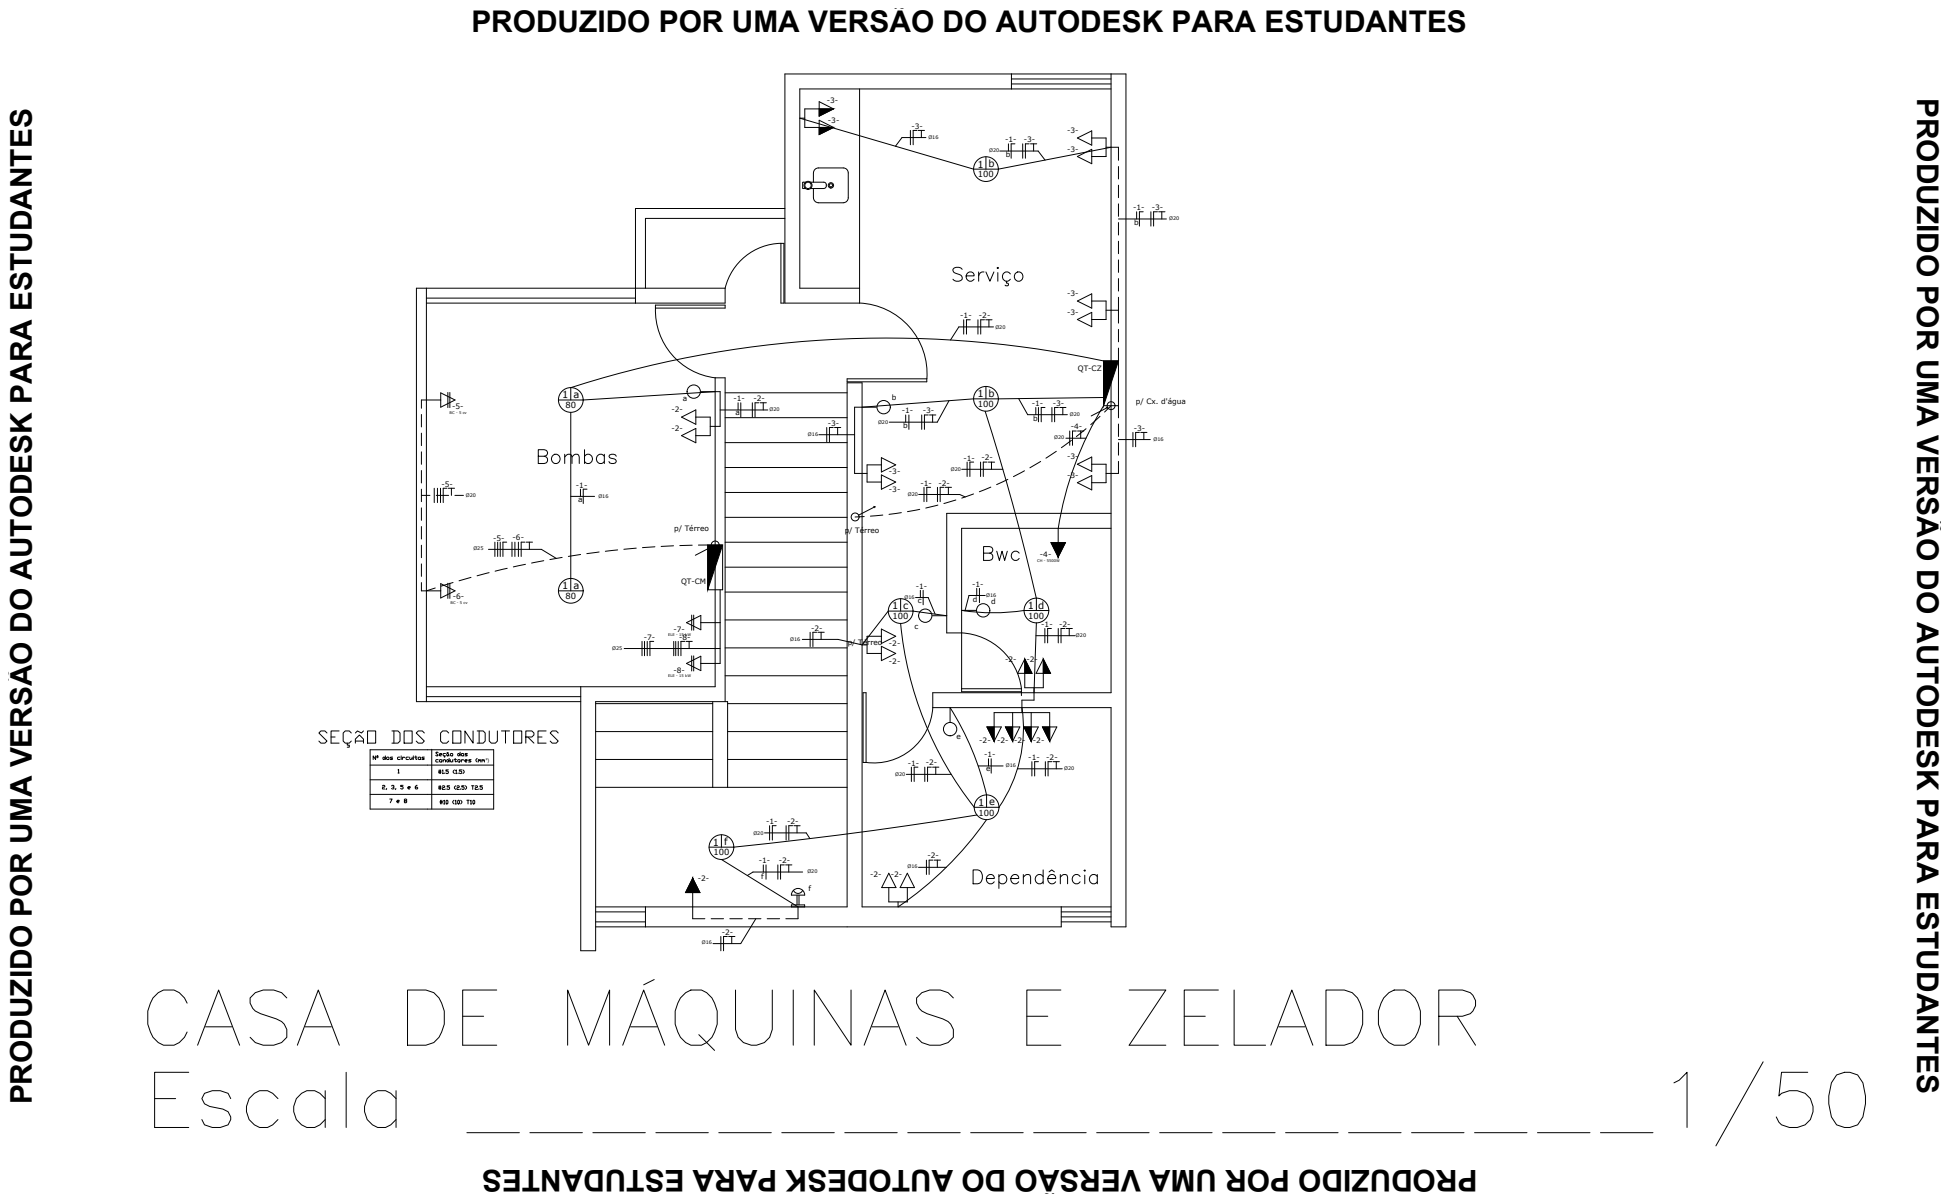
[picture p30: page 1]
ELE - 15 kW; p/ Térreo

PRODUZIDO POR UMA VERSÃO DO AUTODESK PARA ESTUDANTES

p/ Cx. d'água QT-CZ
